eSpark-Backup/shocksensor-george/Hardware-Designing/Deliverables/Renderings/3D_Bottom_View.PNG

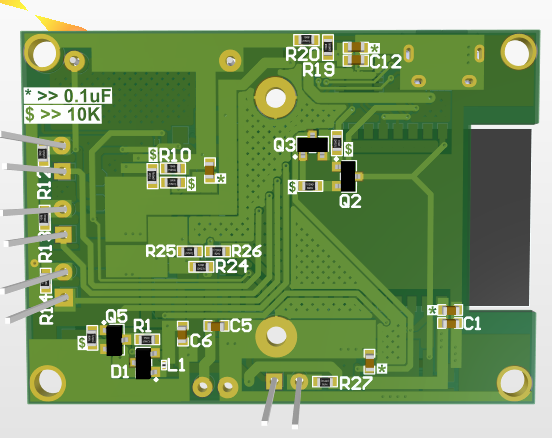
Hardware-Designing/Deliverables/Renderings/3D_Bottom_View.PNG
