eSpark-Backup/shocksensor-george/Hardware-Designing/Deliverables/Renderings/2D_C_View.PNG

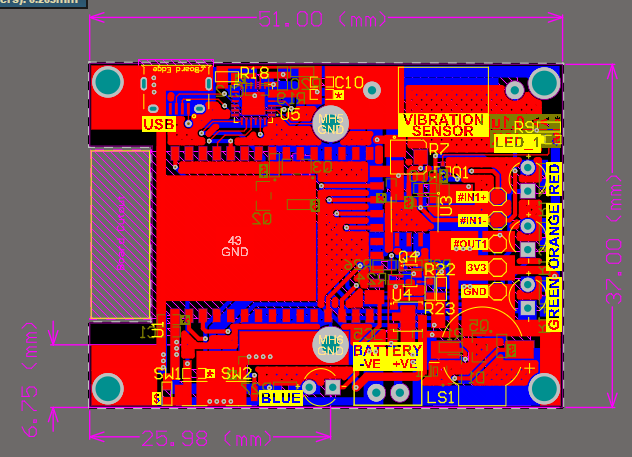
Hardware-Designing/Deliverables/Renderings/2D_C_View.PNG
