eSpark-Backup/shocksensor-george/README.md

# ShockSensor-George
 For Hardware and Software Development of ShockSensor-PCB for Spima Ltd.

## Project Documents
### New Design Proposal
https://docs.google.com/document/d/1cwAtrIecVFzTGOgoKfXupc5CIA_wZs_i1ySnAws0fEk/edit?usp=sharing

### Current Design Rework
https://docs.google.com/document/d/1-ERZRN2x7w0QCunjctplsGUNkxZJDdCkyaSeu2aAGT0/edit#heading=h.7z0ya98mlv53
