eSpark-Backup/shocksensor-george/Hardware-Designing/Design-Files/Shock_Sensor.PcbDoc.htm

Reporting Options

# File in Newer Format

Date | : | 11/3/2021
Time | : | 11:41:44 PM
Filename | : | C:\Users\eSpark-37\Documents\GitHub\ShockSensor-George\Hardware-Designing\Design-Files\Shock_Sensor.PcbDoc

Version | Warning
Release 20.0 | CAUTION - Support of propagation delay for primitives

This file was generated by a later version of the software
