eSpark-Backup/shocksensor-george/Hardware-Designing/Design-Files/MessageListReport.html

Altium customize

# Message List

Date: | | 9/13/2021
Time: | | 1:54:38 AM
Elapsed Time: | | 00:00:00

Class | Document | Source | Message | Time | Date | No.
[Error] | Controller_Section.SchDoc | Compiler | Duplicate Net Names Wire #OUT1 | 1:18:53 AM | 9/13/2021 | 1
[Warning] | Sensor_Section.SchDoc | Compiler | Global Power-Object GND at 1700mil,1050mil has been reduced to local level by presence of port at 1000mil,1050mil | 1:18:53 AM | 9/13/2021 | 2
[Warning] | Power_Section.SchDoc | Compiler | Global Power-Object GND at 1700mil,1050mil has been reduced to local level by presence of port at 1000mil,1050mil | 1:18:53 AM | 9/13/2021 | 3
[Warning] | Controller_Section.SchDoc | Compiler | Global Power-Object GND at 1700mil,1800mil has been reduced to local level by presence of port at 1000mil,1800mil | 1:18:53 AM | 9/13/2021 | 4
[Warning] | Connector_Section.SchDoc | Compiler | Global Power-Object GND at 1700mil,2050mil has been reduced to local level by presence of port at 1000mil,2050mil | 1:18:53 AM | 9/13/2021 | 5
[Warning] | ADC_Section.SchDoc | Compiler | Global Power-Object GND at 1700mil,2050mil has been reduced to local level by presence of port at 1000mil,2050mil | 1:18:53 AM | 9/13/2021 | 6
[Warning] | Power_Section.SchDoc | Compiler | Global Power-Object VBAT at 1700mil,1200mil has been reduced to local level by presence of port at 1000mil,1200mil | 1:18:53 AM | 9/13/2021 | 7
[Warning] | ADC_Section.SchDoc | Compiler | Global Power-Object VBAT at 1700mil,2200mil has been reduced to local level by presence of port at 1000mil,2200mil | 1:18:53 AM | 9/13/2021 | 8
[Warning] | Connector_Section.SchDoc | Compiler | Global Power-Object VBAT at 1700mil,2200mil has been reduced to local level by presence of port at 1000mil,2200mil | 1:18:53 AM | 9/13/2021 | 9
[Warning] | Connector_Section.SchDoc | Compiler | Global Power-Object VBUS at 1700mil,2350mil has been reduced to local level by presence of port at 1000mil,2350mil | 1:18:53 AM | 9/13/2021 | 10
[Warning] | Sensor_Section.SchDoc | Compiler | Global Power-Object VCC_3V3 at 1700mil,1200mil has been reduced to local level by presence of port at 1000mil,1200mil | 1:18:53 AM | 9/13/2021 | 11
[Warning] | Power_Section.SchDoc | Compiler | Global Power-Object VCC_3V3 at 1700mil,1350mil has been reduced to local level by presence of port at 1000mil,1350mil | 1:18:53 AM | 9/13/2021 | 12
[Warning] | Controller_Section.SchDoc | Compiler | Global Power-Object VCC_3V3 at 1700mil,1950mil has been reduced to local level by presence of port at 1000mil,1950mil | 1:18:53 AM | 9/13/2021 | 13
[Warning] | ADC_Section.SchDoc | Compiler | Global Power-Object VCC_3V3 at 1700mil,2350mil has been reduced to local level by presence of port at 1000mil,2350mil | 1:18:53 AM | 9/13/2021 | 14
[Warning] | Connector_Section.SchDoc | Compiler | Global Power-Object VCC_3V3 at 1700mil,2500mil has been reduced to local level by presence of port at 1000mil,2500mil | 1:18:53 AM | 9/13/2021 | 15
[Warning] | Sensor_Section.SchDoc | Compiler | Off grid Net Label #IN1+ at 8315.256mil,2700mil | 1:18:53 AM | 9/13/2021 | 16
[Warning] | Controller_Section.SchDoc | Compiler | Off grid Net Label DTR at 7005mil,4400mil | 1:18:53 AM | 9/13/2021 | 17
[Warning] | Controller_Section.SchDoc | Compiler | Off grid Net Label RTS at 7005mil,3250mil | 1:18:53 AM | 9/13/2021 | 18

Back to top
