eSpark-Backup/shocksensor-george/Hardware-Designing/_Client Shared Files/Shock_Sensor_PCB/bot.png

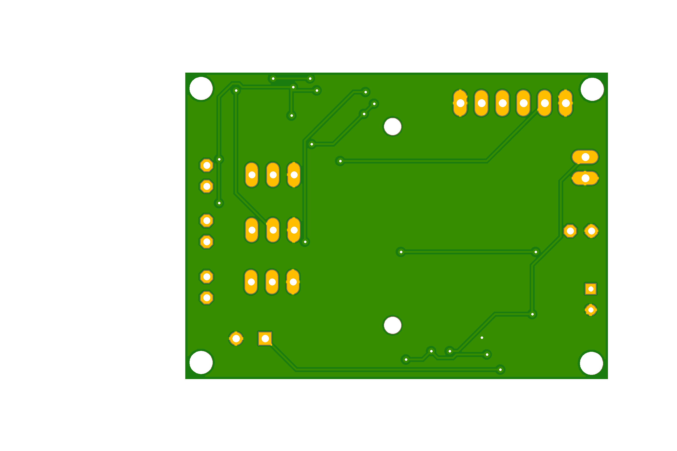
Hardware-Designing/_Client Shared Files/Shock_Sensor_PCB/bot.png
