eSpark-Backup/shocksensor-george/Hardware-Designing/_Shock_Sensor_PCB/top.png

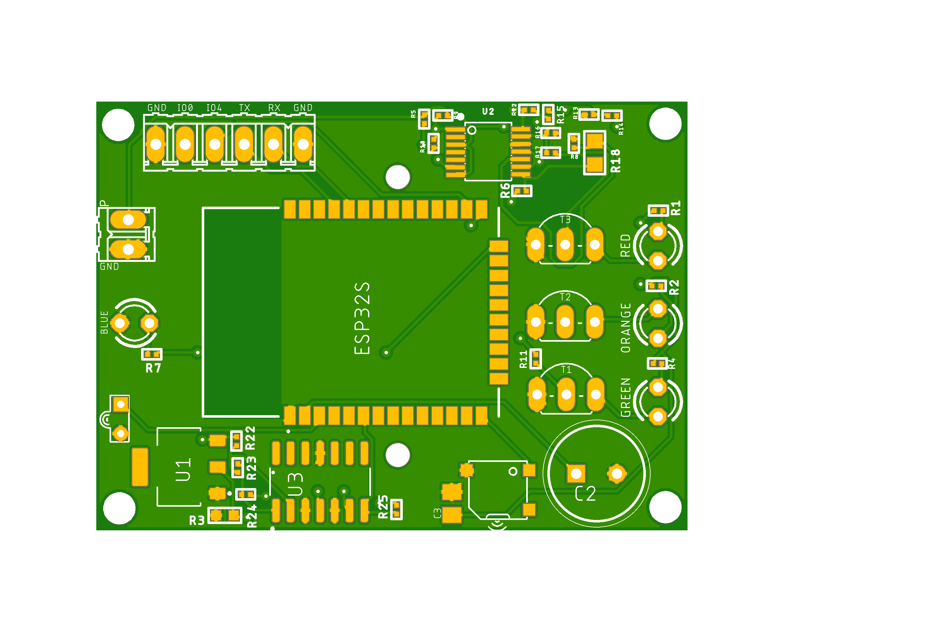
Hardware-Designing/_Shock_Sensor_PCB/top.png
