eSpark-Backup/shocksensor-george/Hardware-Designing/Deliverables/Renderings/2D_Top_View.PNG

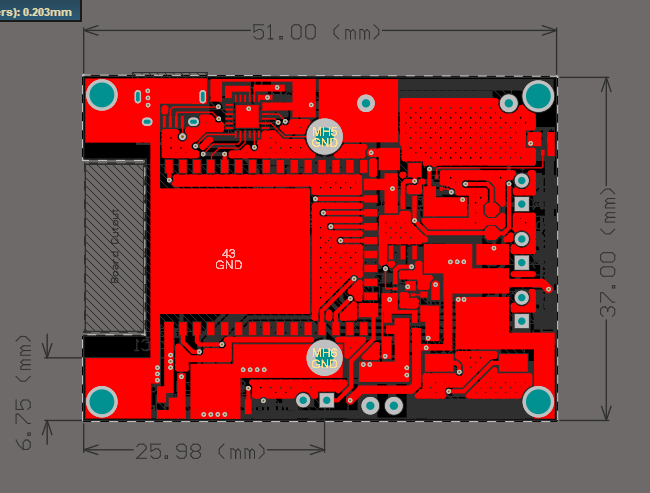
Hardware-Designing/Deliverables/Renderings/2D_Top_View.PNG
