eSpark-Backup/shocksensor-george/Hardware-Designing/Deliverables/Renderings/Isometric_View.PNG

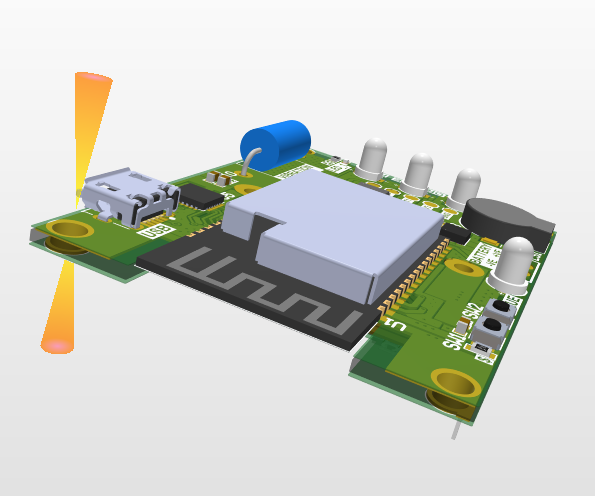
Hardware-Designing/Deliverables/Renderings/Isometric_View.PNG
