eSpark-Backup/shocksensor-george/Hardware-Designing/Deliverables/BOM/Digikey BOM.xlsx

Bill of Material (BOM) for George (Rack Monitor)
S. No. | Components | Description | Designator | Footprint (Package) | Manufacturer Part Number | Manufacturer | Alternate | Value | Quantity (Per Board) | Quantity 5 | Link | Unit Cost(1) | Total Cost(1) | Unit Cost (5 Boards) | Total Cost (5) | Remarks
1 | Capacitors | CAP CER 0.1UF 50V X7R 0603 | C2, C3, C4, C11, C13, C14 | CAP-0603 | CL10B104KB8NNNL | Samsung | - | 0.1uF | 6 | 30 | Digikey (https://www.digikey.com/en/products/detail/samsung-electro-mechanics/CL10B104KB8NNNL/3894274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) | $0.10000 | $0.60000 | $0.03100 | $0.93000
2 |  | CAP CER 22UF 16V X5R 0603 | C1 | CAP-0603 | CL10A226MO7JZNC | Samsung | - | 22uF | 1 | 5 | Digikey (https://www.digikey.com/en/products/detail/samsung-electro-mechanics/CL10A226MO7JZNC/7320581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) | $0.67000 | $0.67000 | $0.67000 | $3.35000
3 |  | CAP CER 4.7UF 25V X5R 0603 | C10, C12 | CAP-0603 | GRM188R61E475KE11D | Murata | - | 4.7uF | 2 | 10 | Digikey (https://www.digikey.com/en/products/detail/murata-electronics/GRM188R61E475KE11D/3900465) | $0.37000 | $0.74000 | $0.25800 | $2.58000
4 |  | CAP CER 1UF 25V X5R 0603 | C5, C6 | CAP-0603 | CL10A105KA8NNNC | Samsung | - | 1uF | 2 | 10 | Digikey (https://www.digikey.com/en/products/detail/samsung-electro-mechanics/CL10A105KA8NNNC/3886760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) | $0.10000 | $0.20000 | $0.03500 | $0.35000
5 | LED | LED GREEN CLEAR CHIP SMD | LED1 | LED 0402 | XZVG68W-2 | SunLED | - | - | 1 | 5 | Digikey (https://www.digikey.com/en/products/detail/sunled/XZVG68W-2/4745975?s=N4IgTCBcDaIBoC0BqBxAbADgOoFoIF0BfIA) | $0.37000 | $0.37000 | $0.37000 | $1.85000
6 |  | LED RED CLEAR T/H | LED2 | Through_Hole_LED | 204-10SURT/S530-A3 | Everlight | - | - | 1 | 5 | Digikey (https://www.digikey.com/en/products/detail/sunled/XLMDK65D/13559277) | $0.39000 | $0.39000 | $0.39000 | $1.95000
7 |  | LED ORANGE CLEAR 3MM T/H | LED3 | Through_Hole_LED | 204-10UYOC/S530-A3-L | Everlight | - | - | 1 | 5 | Digikey (https://www.digikey.com/en/products/detail/vishay-semiconductor-opto-division/TLHF4900/1681231) | $0.52000 | $0.52000 | $0.52000 | $2.60000
8 |  | 3MM YELLOW GREEN LED LAMP | LED4 | Through_Hole_LED | 204-10SYGC/S530-E2-L | Everlight | - | - | 1 | 5 | Digikey (https://www.digikey.com/en/products/detail/american-opto-plus-led/L314GT/13165175) | $0.25000 | $0.25000 | $0.25000 | $1.25000
9 |  | LED BLUE CLEAR 3MM T/H | LED5 | Through_Hole_LED | 204-10SUBC/C470/S400-A4 | Everlight | - | - | 1 | 5 | Digikey (https://www.digikey.com/en/products/detail/inolux/INL-3AB30/7604618) | $0.37000 | $0.37000 | $0.37000 | $1.85000
10 | Diode | DIODE GEN PURP 50V 215MA SOT23 | D1 | sot-23 | BAL74,215 | Nexperia | - | - | 1 | 5 | Digikey (https://www.digikey.com/en/products/detail/nexperia-usa-inc/BAL74-215/1127177) | $0.24000 | $0.24000 | $0.24000 | $1.20000
11 | Mosfet | MOSFET N-Channel 60V 0.115A SOT523 | Q1 | SOT-523 | 2N7002T-7-F | Diodes | - | - | 1 | 5 | Digikey (https://www.digikey.com/en/products/detail/diodes-incorporated/2N7002T-7-F/814963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) | $0.44000 | $0.44000 | $0.44000 | $2.20000
12 |  | TRANS NPN 40V 0.6A SMD SOT23-3 | Q2, Q3 | sot-23 | MMBT2222A-7-F | Diodes | - | - | 2 | 10 | Digikey (https://www.digikey.com/en/products/detail/diodes-incorporated/MMBT2222A-7-F/814503) | $0.14000 | $0.28000 | $0.13200 | $1.32000
13 |  | MOSFET N/P-CH 60V/50V SC70-6 | Q4 | SOT-363 | BSS8402DW-7-F | Diodes | - | - | 1 | 5 | Digikey (https://www.digikey.com/en/products/detail/diodes-incorporated/BSS8402DW-7-F/815002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) | $0.55000 | $0.55000 | $0.55000 | $2.75000
14 |  | MOSFET N-CH 50V 200MA SOT-23 | Q5 | sot-23 | BSS138LT1G | onsemi | - | - | 1 | 5 | Digikey (https://www.digikey.com/en/products/detail/onsemi/BSS138LT1G/918376?s=N4IgTCBcDaIEIGUEEYDMAOAMgFWQcRAF0BfIA) | $0.36000 | $0.36000 | $0.36000 | $1.80000
15 | Inductor | FERRITE BEAD 600 OHM 0201 1LN | L1 | IND 0201 | MMZ0603S601CT000 | TDK Corporation | - | - | 1 | 5 | Digikey (https://www.digikey.com/en/products/detail/tdk-corporation/MMZ0603S601CT000/765038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) | $0.13000 | $0.13000 | $0.13000 | $0.65000
16 | Buzzer | NO 2700Hz 85dB @ 3V, 10cm 3V Φ9mm SMD,9x3.2mm Buzzers RoHS | LS1 | Custom | YS-SBZ9032C03R16 | Fengming | AST0927MW-03TRQ | - | 1 | 5 | Digikey (https://www.digikey.com/en/products/detail/mallory-sonalert-products-inc/AST0927MW-03TRQ/11568847) | $1.64000 | $1.64000 | $1.64000 | $8.20000
17 | Resistors | RES SMD 10K OHM 5% 1/5W 0603 | R2, R6, R8, R11, R15, R16 | RES-0603 | CRGH0603J10K | TE Connectivity | - | 10K | 6 | 30 | Digikey (https://www.digikey.com/en/products/detail/te-connectivity-passive-product/CRGH0603J10K/2385379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) | $0.10000 | $0.60000 | $0.05800 | $1.74000
18 |  | TRIMMER 10K OHM 0.1W J LEAD TOP | R7 | Custom | TC33X-2-103E | Bourns Inc. | - | 10K | 1 | 5 | Digikey (https://www.digikey.com/en/products/detail/bourns-inc/TC33X-2-103E/612858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) | $0.26000 | $0.26000 | $0.26000 | $1.30000
19 |  | RES SMD 4.7K OHM 1% 1/10W 0603 | R9, R26 | RES-0603 | RC0603FR-074K7L | YAGEO | - | 4.7K | 2 | 10 | Digikey (https://www.digikey.com/en/products/detail/yageo/RC0603FR-074K7L/727212) | $0.10000 | $0.20000 | $0.10000 | $1.00000
20 |  | RES 470K OHM 1% 1/10W 0603 | R10 | RES-0603 | RC0603FR-13470KL | YAGEO | - | 470K | 1 | 5 | Digikey (https://www.digikey.com/en/products/detail/yageo/RC0603FR-13470KL/13694191) | $0.10000 | $0.10000 | $0.10000 | $0.50000
21 |  | RES SMD 560 OHM 1% 1/10W 0603 | R12, R13, R14, R27 | RES-0603 | RC0603FR-07560RL | YAGEO | - | 560R | 4 | 20 | Digikey (https://www.digikey.com/en/products/detail/yageo/RC0603FR-07560RL/727304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) | $0.10000 | $0.40000 | $0.02400 | $0.48000
22 |  | RES 1K OHM 5% 1/10W 0603 | R18 | RES-0603 | RMCF0603JJ1K00 | Stackpole | - | 1K | 1 | 5 | Digikey (https://www.digikey.com/en/products/detail/stackpole-electronics-inc/RMCF0603JJ1K00/6053783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) | $0.10000 | $0.10000 | $0.10000 | $0.50000
23 |  | RES SMD 22.1K OHM 1% 1/10W 0603 | R19 | RES-0603 | ERJ-3EKF2212V | Panasonic | - | 22.1K | 1 | 5 | Digikey (https://www.digikey.com/en/products/detail/panasonic-electronic-components/ERJ-3EKF2212V/196218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) | $0.10000 | $0.10000 | $0.10000 | $0.50000
24 |  | RES 47.5K OHM 1% 1/10W 0603 | R20 | RES-0603 | RC0603FR-0747K5L | YAGEO | - | 45.K | 1 | 5 | Digikey (https://www.digikey.com/en/products/detail/yageo/RC0603FR-0747K5L/727255) | $0.10000 | $0.10000 | $0.10000 | $0.50000
25 |  | RES SMD 47 OHM 0.1% 1/10W 0603 | R1 | RES-0603 | RT0603BRD0747RL | YAGEO | - | 47R | 1 | 5 | Digikey (https://www.digikey.com/en/products/detail/yageo/RT0603BRD0747RL/1072545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) | $0.34000 | $0.34000 | $0.34000 | $1.70000
26 |  | RES 100K OHM 5% 1/10W 0603 | R22, R23, R24, R25 | RES-0603 | RC0603JR-07100KL | YAGEO | - | 100K | 4 | 20 | Digikey (https://www.digikey.com/en/products/detail/yageo/RC0603JR-07100KL/726698) | $0.10000 | $0.40000 | $0.10000 | $2.00000
27 | Sensor | Vibration sensor | S1 | Custom | SW-420 | ------- | ---- | - | 1 | 5 | Custom supplier | $1.20000 | $1.20000 | $1.20000 | $6.00000 | will be arrange from custom supplier
28 | Switch | SWITCH TACTILE SPST-NO 0.05A 12V | SW1, SW2 | Custom | B3U-1000P | Omron | - | - | 2 | 10 | Digikey (https://www.digikey.com/en/products/detail/omron-electronics-inc-emc-div/B3U-1000P/1534338) | $0.96000 | $1.92000 | $0.92700 | $9.27000
29 | IC | 18x31x3.3mm WiFi Modules ROHS | U1 | Custom | ESP32-S2-WROOM-I(4M) | Espressif Systems | - | - | 1 | 5 | Custom supplier | $4.80000 | $4.80000 | $4.80000 | $24.00000 | will be arrange from custom supplier
30 |  | IC COMP DUAL VOLT LP 8SOIC | U3 | 8-SOIC | LM393ADT | STMicroelectronics | - | - | 1 | 5 | Digikey (https://www.digikey.com/en/products/detail/stmicroelectronics/LM393ADT/725475) | $0.43000 | $0.43000 | $0.43000 | $2.15000
31 |  | IC REG LINEAR 3.3V 1A 6DFN | U4 | 6-DFN (3x3) | NCP692MN33T2G | onsemi | - | - | 1 | 5 | Digikey (https://www.digikey.com/en/products/detail/onsemi/NCP692MN33T2G/2194205) | $1.11000 | $1.11000 | $1.11000 | $5.55000
32 |  | IC USB TO UART BRIDGE QFN24 | U5 | QFN-24 | CP2102N-A02-GQFN24R | Silicon Labs | - | - | 1 | 5 | Mouser (https://eu.mouser.com/ProductDetail/Silicon-Labs/CP2102N-A02-GQFN24R) | $1.88000 | $1.88000 | $1.88000 | $9.40000
33 | Connector | CONN RCPT USB2.0 MICRO B SMD R/A | J1 | Custom | 10118194-0001LF | Amphenol | - | - | 1 | 5 | Digikey (https://www.digikey.com/en/products/detail/amphenol-icc-fci/10118194-0001LF/2785389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) | $0.45000 | $0.45000 | $0.45000 | $2.25000
34 |  | ~~Solder Bridge ON~~ | ~~SB1~~ | ~~Solder Bridge~~ | ~~Solder Bridge~~ | ~~----------~~ | ~~----------~~ | ~~-~~ | ~~1~~ | ~~5~~ | ~~-------~~ | ~~--------~~ | ~~----------~~ | ~~-------~~ | ~~-------~~ | ~~Do Not Mount~~
35 |  | ~~Test Point ON~~ | ~~P1, P2, P3, P4, P5~~ | ~~Custom~~ | ~~TEST POINT~~ | ~~--------~~ | ~~-----------~~ | ~~-~~ | ~~5~~ | ~~25~~ | ~~-------~~ | ~~-------~~ | ~~--------~~ | ~~--------~~ | ~~-------~~ | ~~Do Not Mount~~
 |  |  |  |  |  |  |  |  | Total Component Cost |  |  |  | $22.14 |  | $103.67
 |  |  |  |  |  |  |  |  | Single Board Cost |  |  |  | $22.14 |  | $20.73
