eSpark-Backup/shocksensor-george/Hardware-Designing/Deliverables/BOM/LCSC BOM.xlsx

Bill of Material (BOM) for George (Rack Monitor)
S. No. | Components | Description | Designator | Footprint (Package) | Manufacturer Part Number | Manufacturer | LCSC Part no: | Alternate | Value | Quantity (Per Board) | Quantity 5 | LCSC MOQ (1) | LCSC MOQ (5) | LCSC Link | Unit Cost(1) | Total Cost(1) | Unit Cost (5 Boards) | Total Cost (5) | Remarks
1 | Capacitors | CAP CER 0.1UF 50V X7R 0603 | C2, C3, C4, C11, C13, C14 | CAP-0603 | ~~CL10B104KB8NNNL~~ | Samsung | C76711 | CGA3E2X7R1H104KT0Y0N | 0.1uF | 6 | 30 | 50 | 50 | LCSC (https://www.lcsc.com/product-detail/Multilayer-Ceramic-Capacitors-MLCC-SMD-SMT_TDK-CGA3E2X7R1H104KT0Y0N_C76711.html) | $0.01270 | $0.63500 | $0.01270 | $0.63500
2 |  | CAP CER 22UF 16V X5R 0603 | C1 | CAP-0603 | CL10A226MO7JZNC | Samsung | C2762594 | - | 22uF | 1 | 5 | 5 | 10 | LCSC (https://www.lcsc.com/product-detail/Multilayer-Ceramic-Capacitors-MLCC-SMD-SMT_Samsung-Electro-Mechanics-CL10A226MO7JZNC_C2762594.html) | $0.17260 | $0.86300 | $0.17260 | $1.72600
3 |  | CAP CER 4.7UF 25V X5R 0603 | C10, C12 | CAP-0603 | GRM188R61E475KE11D | Murata | C90057 | - | 4.7uF | 2 | 10 | 10 | 20 | LCSC (https://www.lcsc.com/product-detail/Multilayer-Ceramic-Capacitors-MLCC-SMD-SMT_Murata-Electronics-GRM188R61E475KE11D_C90057.html) | $0.08160 | $0.81600 | $0.08160 | $1.63200
4 |  | CAP CER 1UF 25V X5R 0603 | C5, C6 | CAP-0603 | CL10A105KA8NNNC | Samsung | C5673 | - | 1uF | 2 | 10 | 50 | 50 | LCSC (https://www.lcsc.com/product-detail/Multilayer-Ceramic-Capacitors-MLCC-SMD-SMT_Samsung-Electro-Mechanics-CL10A105KA8NNNC_C5673.html) | $0.00440 | $0.22000 | $0.00440 | $0.22000
5 | LED | LED GREEN CLEAR CHIP SMD | LED1 | LED 0402 | ~~XZVG68W-2~~ | SunLED | C273602 | TJ-S1005SW4TGLC2G-A5 | - | 4 | 20 | 10 | 30 | LCSC (https://www.lcsc.com/product-detail/Light-Emitting-Diodes-span-style-background-color-ff0-LED-span_TOGIALED-TJ-S1005SW4TGLC2G-A5_C273602.html) | $0.05940 | $0.59400 | $0.05940 | $1.78200
6 |  | LED RED CLEAR T/H | LED2 | Through_Hole_LED | 204-10SURT/S530-A3 | Everlight | C282135 | - | - | 1 | 5 | 10 | 10 | LCSC (https://www.lcsc.com/product-detail/Light-Emitting-Diodes-LED_Everlight-Elec-204-10SURT-S530-A3_C282135.html) | $0.04220 | $0.42200 | $0.04220 | $0.42200
7 |  | LED ORANGE CLEAR 3MM T/H | LED3 | Through_Hole_LED | 204-10UYOC/S530-A3-L | Everlight | C99759 | - | - | 1 | 5 | 10 | 10 | LCSC (https://www.lcsc.com/product-detail/Light-Emitting-Diodes-LED_Everlight-Elec-204-10UYOC-S530-A3-L_C99759.html) | $0.05660 | $0.56600 | $0.05660 | $0.56600
8 |  | 3MM YELLOW GREEN LED LAMP | LED4 | Through_Hole_LED | 204-10SYGC/S530-E2-L | Everlight | C282136 | - | - | 1 | 5 | 10 | 10 | LCSC (https://www.lcsc.com/product-detail/Light-Emitting-Diodes-LED_Everlight-Elec-204-10SYGC-S530-E2-L_C282136.html) | $0.04260 | $0.42600 | $0.04260 | $0.42600
9 |  | LED BLUE CLEAR 3MM T/H | LED5 | Through_Hole_LED | 204-10SUBC/C470/S400-A4 | Everlight | C86726 | - | - | 1 | 5 | 5 | 10 | LCSC (https://www.lcsc.com/product-detail/Light-Emitting-Diodes-LED_Everlight-Elec-204-10SUBC-C470-S400-A4_C86726.html) | $0.10130 | $0.50650 | $0.10130 | $1.01300
10 | Diode | DIODE GEN PURP 50V 215MA SOT23 | D1 | sot-23 | BAL74,215 | Nexperia | C461224 | - | - | 1 | 5 | 10 | 10 | LCSC (https://www.lcsc.com/product-detail/Diodes-General-Purpose_Nexperia-BAL74-215_C461224.html) | $0.06170 | $0.61700 | $0.06170 | $0.61700
11 | Mosfet | MOSFET N-Channel 60V 0.115A SOT523 | Q1 | SOT-523 | 2N7002T-7-F | Diodes | C139445 | - | - | 1 | 5 | 2 | 7 | LCSC (https://www.lcsc.com/product-detail/MOSFETs_Diodes-Incorporated-2N7002T-7-F_C139445.html) | $0.24880 | $0.49760 | $0.24880 | $1.74160
12 |  | TRANS NPN 40V 0.6A SMD SOT23-3 | Q2, Q3 | sot-23 | MMBT2222A-7-F | Diodes | C94515 | - | - | 2 | 10 | 20 | 20 | LCSC (https://www.lcsc.com/product-detail/Bipolar-Transistors-BJT_Diodes-Incorporated-MMBT2222A-7-F_C94515.html) | $0.05060 | $1.01200 | $0.05060 | $1.01200
13 |  | MOSFET N/P-CH 60V/50V SC70-6 | Q4 | SOT-363 | BSS8402DW-7-F | Diodes | C156386 | - | - | 1 | 5 |  |  | Chipmall (https://www.chipmall.com/product_detail/Diodes-Incorporated/MOSFET/BSS8402DW-7-F_740484.html) | $0.08810 | $0.00000 | $0.08810 | $0.00000 | Non Stock in LCSC
14 |  | MOSFET N-CH 50V 200MA SOT-23 | Q5 | sot-23 | BSS138LT1G | onsemi | C82045 | - | - | 1 | 5 | 2 | 7 | LCSC (https://www.lcsc.com/product-detail/MOSFETs_onsemi-BSS138LT1G_C82045.html) | $0.18090 | $0.36180 | $0.18090 | $1.26630
15 | Inductor | FERRITE BEAD 600 OHM 0201 1LN | L1 | IND 0201 | MMZ0603S601CT000 | TDK Corporation | C275404 | - | - | 1 | 5 | 50 | 50 | LCSC (https://www.lcsc.com/product-detail/Ferrite-Beads_TDK-MMZ0603S601CT000_C275404.html) | $0.00540 | $0.27000 | $0.00540 | $0.27000
16 | Buzzer | NO 2700Hz 85dB @ 3V, 10cm 3V Φ9mm SMD,9x3.2mm Buzzers RoHS | LS1 | Custom | YS-SBZ9032C03R16 | Fengming | C409828 | - | - | 1 | 5 | 2 | 7 | LCSC (https://www.lcsc.com/product-detail/Buzzers_Fengming-YS-SBZ9032C03R16_C409828.html) | $0.54280 | $1.08560 | $0.54280 | $3.79960
17 | Resistors | RES SMD 10K OHM 5% 1/5W 0603 | R2, R6, R8, R11, R15, R16 | RES-0603 | ~~CRGH0603J10K~~ | TE Connectivity | C103210 | RTT03103JTP | 10K | 5 | 25 | 100 | 100 | LCSC (https://www.lcsc.com/product-detail/Chip-Resistor-Surface-Mount_RALEC-RTT03103JTP_C103210.html) | $0.00140 | $0.14000 | $0.00140 | $0.14000
18 |  | TRIMMER 10K OHM 0.1W J LEAD TOP | R7 | Custom | TC33X-2-103E | Bourns Inc. | - | - | 10K | 1 | 5 |  |  | Local Supplier | $0.47620 | $0.00000 | $0.47620 | $0.00000
19 |  | RES SMD 4.7K OHM 1% 1/10W 0603 | R9, R26 | RES-0603 | RC0603FR-074K7L | YAGEO | C99782 | - | 4.7K | 2 | 10 | 100 | 100 | LCSC (https://www.lcsc.com/product-detail/Chip-Resistor-Surface-Mount_YAGEO-RC0603FR-074K7L_C99782.html) | $0.00130 | $0.13000 | $0.00130 | $0.13000
20 |  | RES 470K OHM 1% 1/10W 0603 | R10 | RES-0603 | ~~RC0603FR-13470KL~~ | YAGEO | C103658 | RTT034703FTP | 470K | 1 | 5 | 100 | 100 | LCSC (https://www.lcsc.com/product-detail/Chip-Resistor-Surface-Mount_RALEC-RTT034703FTP_C103658.html) | $0.00240 | $0.24000 | $0.00240 | $0.24000
21 |  | RES SMD 560 OHM 1% 1/10W 0603 | R12, R13, R14 | RES-0603 | RC0603FR-07560RL | YAGEO | C114629 | - | 560R | 3 | 15 | 100 | 100 | LCSC (https://www.lcsc.com/product-detail/Chip-Resistor-Surface-Mount_YAGEO-RC0603FR-07560RL_C114629.html) | $0.00150 | $0.15000 | $0.00150 | $0.15000
22 |  | RES 1K OHM 5% 1/10W 0603 | R18 | RES-0603 | RMCF0603JJ1K00 | Stackpole | C103209 | - | 1K | 1 | 5 | 100 | 100 | LCSC (https://www.lcsc.com/product-detail/Chip-span-style-background-color-ff0-Resistor-span-Surface-Mount_RALEC-RTT03102JTP_C103209.html) | $0.00120 | $0.12000 | $0.00120 | $0.12000
23 |  | RES SMD 22.1K OHM 1% 1/10W 0603 | R19 | RES-0603 | ERJ-3EKF2212V | Panasonic | C25961 | - | 22.1K | 1 | 5 | 100 | 100 | LCSC (https://www.lcsc.com/product-detail/Chip-span-style-background-color-ff0-Resistor-span-Surface-Mount_UNI-ROYAL-Uniroyal-Elec-0603WAF2212T5E_C25961.html) | $0.00140 | $0.14000 | $0.00140 | $0.14000
24 |  | RES 47.5K OHM 1% 1/10W 0603 | R20 | RES-0603 | RC0603FR-0747K5L | YAGEO | C137715 | - | 47.5K | 1 | 5 | 100 | 100 | LCSC (https://www.lcsc.com/product-detail/Chip-Resistor-Surface-Mount_YAGEO-RC0603FR-0747K5L_C137715.html) | $0.00140 | $0.14000 | $0.00140 | $0.14000
25 |  | RES SMD 47 OHM 0.1% 1/10W 0603 | R1 | RES-0603 | RT0603BRD0747RL | YAGEO | C326724 | - | 47R | 1 | 5 | 20 | 20 | LCSC (https://www.lcsc.com/product-detail/Chip-Resistor-Surface-Mount_YAGEO-RT0603BRD0747RL_C326724.html) | $0.03680 | $0.73600 | $0.03680 | $0.73600
26 |  | RES 100K OHM 5% 1/10W 0603 | R22, R23, R24, R25 | RES-0603 | RC0603JR-07100KL | YAGEO | C100048 | - | 100K | 4 | 20 | 100 | 100 | LCSC (https://www.lcsc.com/product-detail/Chip-Resistor-Surface-Mount_YAGEO-RC0603JR-07100KL_C100048.html) | $0.00110 | $0.11000 | $0.00110 | $0.11000
27 | Sensor | Vibration sensor | S1 | Custom | SW-420 | - | - | - | - | 1 | 5 |  |  | Local Supplier | $0.31800 | $0.00000 | $0.31800 | $0.00000 | Non Stock in LCSC
28 | Switch | SWITCH TACTILE SPST-NO 0.05A 12V | SW1, SW2 | Custom | B3U-1000P | Omron | C231329 | - | - | 2 | 10 | 3 | 12 | LCSC (https://www.lcsc.com/product-detail/Tactile-Switches_Omron-Electronics-B3U-1000P_C231329.html) | $0.82230 | $2.46690 | $0.69070 | $8.28840
29 | IC | 18x31x3.3mm WiFi Modules ROHS | U1 | Custom | ESP32-S2-WROOM-I(4M) | Espressif Systems | C967026 | - | - | 1 | 5 | 2 | 6 | LCSC (https://lcsc.com/product-detail/WiFi-Modules_Espressif-Systems-ESP32-S2-WROOM-I-4M_C967026.html) | $5.05280 | $10.10560 | $5.05280 | $30.31680
30 |  | IC COMP DUAL VOLT LP 8SOIC | U3 | 8-SOIC | LM393ADT | STMicroelectronics | C136033 | - | - | 1 | 5 | 2 | 6 | LCSC (https://www.lcsc.com/product-detail/Comparators_STMicroelectronics-LM393ADT_C136033.html) | $0.29740 | $0.59480 | $0.29740 | $1.78440
31 |  | IC REG LINEAR 3.3V 1A 6DFN | U4 | 6-DFN (3x3) | NCP692MN33T2G | onsemi | C145519 | - | - | 1 | 5 | 2 | 6 | LCSC (https://www.lcsc.com/product-detail/Linear-Voltage-Regulators-LDO_onsemi-NCP692MN33T2G_C145519.html) | $1.70230 | $3.40460 | $1.70230 | $10.21380 | Less Stock in LCSC
32 |  | IC USB TO UART BRIDGE QFN24 | U5 | QFN-24_4x4 | CP2102N-A02-GQFN24R | Silicon Labs | C969151 | - | - | 1 | 5 | 2 | 6 | LCSC (https://www.lcsc.com/product-detail/USB-ICs_SILICON-LABS-CP2102N-A02-GQFN24R_C969151.html) | $5.20790 | $10.41580 | $5.20790 | $31.24740
33 | Connector | CONN RCPT USB2.0 MICRO B SMD R/A | J1 | Custom | 10118194-0001LF | Amphenol | C132563 | - | - | 1 | 5 | 2 | 6 | LCSC (https://www.lcsc.com/product-detail/USB-Connectors_Amphenol-ICC-10118194-0001LF_C132563.html) | $0.26130 | $0.52260 | $0.26130 | $1.56780
34 |  | ~~Solder Bridge ON~~ | ~~SB1~~ | ~~Custom~~ | ~~Solder Bridge~~ | ~~-~~ | ~~-~~ | ~~-~~ | ~~-~~ | ~~1~~ | ~~5~~ | ~~-~~ | ~~-~~ | ~~-~~ | ~~-~~ | ~~-~~ | ~~-~~ | ~~-~~ | ~~DONOT MOUNT~~
35 |  | ~~Test Point ON~~ | ~~P1, P2, P3, P4, P5~~ | ~~Custom~~ | ~~TEST POINT~~ | ~~-~~ | ~~-~~ | ~~-~~ | ~~-~~ | ~~5~~ | ~~25~~ | ~~-~~ | ~~-~~ | ~~-~~ | ~~-~~ | ~~-~~ | ~~-~~ | ~~-~~ | ~~DONOT MOUNT~~
 |  |  |  |  |  |  |  |  |  | Total Component Cost |  |  |  |  |  | $38.30880 |  | $102.45310
 |  |  |  |  |  |  |  |  |  | Single Board Cost |  |  |  |  |  |  |  | $20.49062
