eSpark-Backup/shocksensor-george/Hardware-Designing/_Client Shared Files/Shock_Sensor_PCB/BOM.xlsx

Part | Value | Device | Package | Description
BATTERY | MP-4-3 TAKACHI ELECTRONICS ENCLOSURE TAKACHI ELECTRONICS ENCLOSURE | M02 | 02P | AMP QUICK CONNECTOR
BLUE | Blue | LED3MM | LED3MM | LED
C2 | ECA0JM102BJ | ECA0JM102BJ | CAPPRD350W65D825H1250 | Cap Aluminum Lytic 1000uF 6.3V 20% (8 X 11.5mm) Radial 580mA 2000h 85C
C3 | 100uF | C-USC0805K | C0805K | CAPACITOR, American symbol
ESP32S | ESP-32S | ESP-32S | ESP-32S | WiFi-BT-BLE MCU module
GREEN | Green | LED3MM | LED3MM | LED
ORANGE | Orange | LED3MM | LED3MM | LED
R1 | ERJ-UP3J221V | R_0201 | R0201 | RESISTOR
R2 | ERJ-UP3J221V | R_0201 | R0201 | RESISTOR
R3 | RNCF0603DTE10K0 | R_0603 | R0603 | RESISTOR
R4 | ERJ-UP3J221V | R_0201 | R0201 | RESISTOR
R5 | RMCF0201JT10K0 | R_0201 | R0201 | RESISTOR
R6 | RMCF0201JT20K0 | R_0201 | R0201 | RESISTOR
R7 | ERJ-UP3J221V | R_0201 | R0201 | RESISTOR
R8 | RMCF0201JT10K0 | R_0201 | R0201 | RESISTOR
R9 | RMCF0201JT10K0 | R_0201 | R0201 | RESISTOR
R10 | RMCF0201JT10K0 | R_0201 | R0201 | RESISTOR
R11 | RMCF0201JT10K0 | R_0201 | R0201 | RESISTOR
R12 | RMCF0201JT10K0 | R_0201 | R0201 | RESISTOR
R13 | RMCF0201JT10K0 | R_0201 | R0201 | RESISTOR
R14 | RMCF0201JT10K0 | R_0201 | R0201 | RESISTOR
R15 | RMCF0201JT10K0 | R_0201 | R0201 | RESISTOR
R16 | RMCF0201JT10K0 | R_0201 | R0201 | RESISTOR
R17 | RMCF0201JT10K0 | R_0201 | R0201 | RESISTOR
R18 | PNM0805E5002BST5 | R_0805 | C0805 | RESISTOR
R22 | RMCF0201JT6K20 | R_0201 | R0201 | RESISTOR
R23 | RC0201JR-0710KL | R_0201 | R0201 | RESISTOR
R24 | RC0201JR-0710KL | R_0201 | R0201 | RESISTOR
R25 | RC0201JR-0710KL | R_0201 | R0201 | RESISTOR
RED | RED | LED3MM | LED3MM | LED
SL1 | Adafruit 2135 | M06 | 06P | AMP QUICK CONNECTOR
SPK1 | SMT-0540-S-R | SMT-0540-S-R | SMT-0540-S-R | SMT-0549-S-R
T1 | 2N2222 | 2N2222 | TO92-EBC-OVAL | NPN TRANSISTOR
T2 | 2N2222 | 2N2222 | TO92-EBC-OVAL | NPN TRANSISTOR
T3 | 2N2222 | 2N2222 | TO92-EBC-OVAL | NPN TRANSISTOR
U$1 | SW-18015P | SW-18015P | SW-18015P
U1 | AMS1117-3.3 | AMS1117-3.3 | SOT229P700X180-4N | Sot223/Pkg 1-Amp 3.3-Volt Low Drop Out Voltage Regulatator
U2 | LM339PWR | LM339 | TSSOP-14 | Quad Comparator - LM339PWR
U3 | LM324DR | LM324DR | SOIC127P600X175-14N | Check prices
