eSpark-Backup/shocksensor-george/Hardware-Designing/Deliverables/Rackmonitor.xlsx

Bill of Material (BOM) for Shock Sensor
S. No. | Components | Description | Designator | Footprint (Package) | Manufacturer Part Number | Manufacturer | LCSC Part no: | Alternate | Value | Quantity (Per Board) | Total MOQ | Quantity 5 | LCSC Link | Unit Cost(1) | Total Cost(1) | MOQ Total | Unit Cost (5 Boards) | Total Cost (5) | Remarks
1 | Capacitor | CL10 Series 0603 0.1 uF 50 V ±10% Tolerance X7R Multilayer Ceramic Capacitor, CAP CER 0.1UF 50V X7R 0603 | C1, C2, C3, C4, C11, C13 | CAP-0603 | CL10B104KB8NNNL | Samsung | C913912 | CC0603KRX7R9BB104 | 0.1uF | 6 | 100 | 30 | LCSC (https://www.lcsc.com/product-detail/Multilayer-Ceramic-Capacitors-MLCC-SMD-SMT_YAGEO-CC0603KRX7R9BB104_C14663.html) | 0.003 |  |  | 0.003
2 |  | Ceramic capacitor SMD-0603 1000nF/25V X7R# K +-10%, Samsung, RoHS | C5, C6 | CAP-0603 | CL10A105KA8NNNC | Samsung | C5673 |  | 1uF | 2 | 50 | 10 | LCSC (https://www.lcsc.com/product-detail/Multilayer-Ceramic-Capacitors-MLCC-SMD-SMT_Samsung-Electro-Mechanics-CL10A105KA8NNNC_C5673.html) | 0.0051 |  |  | 0.0051
3 |  | CAP CER 4.7UF 25V X5R 0603 | C10, C12 | CAP-0603 | GRM188R61E475KE11D | Murata | C90057 |  | 4.7uF | 2 | 20 | 10 | LCSC (https://www.lcsc.com/product-detail/Multilayer-Ceramic-Capacitors-MLCC-SMD-SMT_Murata-Electronics-GRM188R61E475KE11D_C90057.html) | 0.0576 |  |  | 0.0576
4 | LED | LED GREEN CLEAR CHIP SMD | D1, D2, D3, D4 | LED 0402 | XZVG68W-2 | SunLED | C273602 | TJ-S1005SW4TGLC2G-A5 |  | 4 | 30 | 20 | LCSC (https://www.lcsc.com/product-detail/Light-Emitting-Diodes-LED_TOGIALED-TJ-S1005SW4TGLC2G-A5_C273602.html) | 0.0632 |  |  | 0.0632
5 | Mosefet | MOSFET N-Channel 60V 0.115A SOT523 | Q1 | SOT-523 | 2N7002T-7-F | Diodes | C139445 |  |  | 1 | 10 | 5 | LCSC (https://www.lcsc.com/product-detail/MOSFETs_Diodes-Incorporated-2N7002T-7-F_C139445.html) | 0.1124 |  |  | 0.1124
6 |  | Trans GP BJT NPN 40V 0.6A 3-Pin SOT-23 T/R | Q2, Q3 | sot-23 | MMBT2222A-7-F | Diodes | C94515 |  |  | 2 | 20 | 10 | LCSC (https://www.lcsc.com/product-detail/Bipolar-Transistors-BJT_Diodes-Incorporated-MMBT2222A-7-F_C94515.html) | 0.0354 |  |  | 0.0354
7 | Resistor | Surface Mount Thick Film Resistor, CRG Series, 10 kohm, 200 mW, - 5%, 50 V, 0603 [1608 Metric] ;RoHS Compliant: Yes | R6, R8, R11, R15, R16 | RES-0603 | CRGH0603J10K | TE Connectivity Holsworthy | C103210 | RTT03103JTP | 10K | 5 | 100 | 25 | LCSC (https://www.lcsc.com/product-detail/Chip-Resistor-Surface-Mount_RALEC-RTT03103JTP_C103210.html) | 0.0012 |  |  | 0.0012
8 |  | TRIMMER 10K OHM 0.1W J LEAD TOP | R7 | TC33X-2-103E | TC33X-2-103E | Bourns |  |  | 10K | 1 |  | 5
9 |  | RES SMD 4.7K OHM 1% 1/10W 0603 | R9, R26 | RES-0603 | RC0603FR-074K7L | Yageo | C99782 |  | 4.7K | 2 | 100 | 10 | LCSC (https://www.lcsc.com/product-detail/Chip-Resistor-Surface-Mount_YAGEO-RC0603FR-074K7L_C99782.html) | 0.0016 |  |  | 0.0016
10 |  | Thick Film Resistors - SMD 470K OHM 1% | R10 | RES-0603 | RC0603FR-13470KL | Yageo | C103658 | RTT034703FTP | 470K | 1 | 100 | 5 | LCSC (https://www.lcsc.com/product-detail/Chip-Resistor-Surface-Mount_RALEC-RTT034703FTP_C103658.html) | 0.0017 |  |  | 0.0017
11 |  | YAGEO - RC0603FR-07560RL - SMD Chip Resistor, 0603 [1608 Metric], 560 ohm, RC Series, 75 V, Thick Film, 100 mW | R12, R13, R14 | RES-0603 | RC0603FR-07560RL | Yageo | C114629 |  | 560R | 3 | 100 | 15 | LCSC (https://www.lcsc.com/product-detail/Chip-Resistor-Surface-Mount_YAGEO-RC0603FR-07560RL_C114629.html) | 0.0019 |  |  | 0.0019
12 |  | RES 1K OHM 5% 1/10W 0603 | R18 | RES-0603 | RMCF0603JJ1K00 | Stackpole Electronics |  |  | 1K | 1 |  | 5
13 |  | RES SMD 22.1K OHM 1% 1/10W 0603 | R19 | RES-0603 | ERJ-3EKF2212V | Panasonic |  |  | 22.1K | 1 |  | 5
14 |  | Res Thick Film 0603 47.5K Ohm 1% 0.1W(1/10W) ±100ppm/C Epoxy SMD T/R | R20 | RES-0603 | RC0603FR-0747K5L | Yageo |  |  | 47.5K | 1 |  | 5
15 |  | RES SMD 0 OHM JUMPER 1/10W 0603 | R21 | RES-0603 | RC0603JR-070RP | Yageo |  |  | 0R | 1 |  | 5
16 |  | Res Thick Film 0603 100K Ohm 5% 1/10W 100ppm/C Molded SMD SMD Paper T/R | R22, R23, R24, R25 | RES-0603 | RC0603JR-07100KL | Yageo |  |  | 100K | 4 |  | 20
17 | Sensor | Vibration sensor | S1 | SW-420 | SW-420 |  |  |  |  | 1 |  | 5
18 | Switch | SWITCH TACTILE SPST-NO 0.05A 12V | SW1, SW2 | B3U-1000P | B3U-1000P | Omron |  |  |  | 2 |  | 10
19 | ICs | RX TXRX MOD WIFI TRACE ANT SMD | U1 | ESP32-WROOM-32D (8MB) | ESP32-WROOM-32D (8MB) | Espressif Systems |  |  |  | 1 |  | 5
20 |  | STMICROELECTRONICS - LM393ADT - Analogue Comparator, Low Power, 2 Comparators, 300 ns, 2V to 36V, ± 1V to ± 18V, SOIC, 8 Pins | U3 | 8-SOIC | LM393ADT | STMicroelectronics |  |  |  | 1 |  | 5
21 |  | ON Semiconductor NCP692MN33T2G, LDO Voltage Regulator, 1A, 3.3 V 2%, 1.5 6 Vin, 6-Pin DFN | U4 | 6-DFN (3x3) | NCP692MN33T2G | ON Semiconductor |  |  |  | 1 |  | 5
22 |  | IC USB TO UART BRIDGE QFN24 | U5 | CP2102N-A02-GQFN24R | CP2102N-A02-GQFN24R | Silicon Labs |  |  |  | 1 |  | 5
23 |  | DIODES INC. - BSS8402DW-7-F - Dual MOSFET, N and P Channel, 115 mA, 60 V, 13.5 ohm, 10 V, 2.5 V | U6 | SOT-363 | BSS8402DW-7-F | Diodes |  |  |  | 1 |  | 5
24 | Connector | CONN RCPT USB2.0 MICRO B SMD R/A | J1 | 10118194-0001LF | 10118194-0001LF | Amphenol FCI |  |  |  | 1 |  | 5
25 |  | Conn Shrouded Header (4 Sides) HDR 2 POS 2.5mm Solder ST Thru-Hole Box | J2 | B2B-XH-A(LF)(SN) | B2B-XH-A(LF)(SN) | JST |  |  |  | 1 |  | 5
26 |  | Test Point ON | P1, P2, P3, P4, P5 | TEST POINT | TEST POINT |  |  |  |  | 5 |  | 25
27 |  | Solder Bridge ON | SB1 | Solder Bridge | Solder Bridge |  |  |  |  | 1 |  | 5
