eSpark-Backup/shocksensor-george/Hardware-Designing/Deliverables/Supporting Files/Shock_Sensor.step

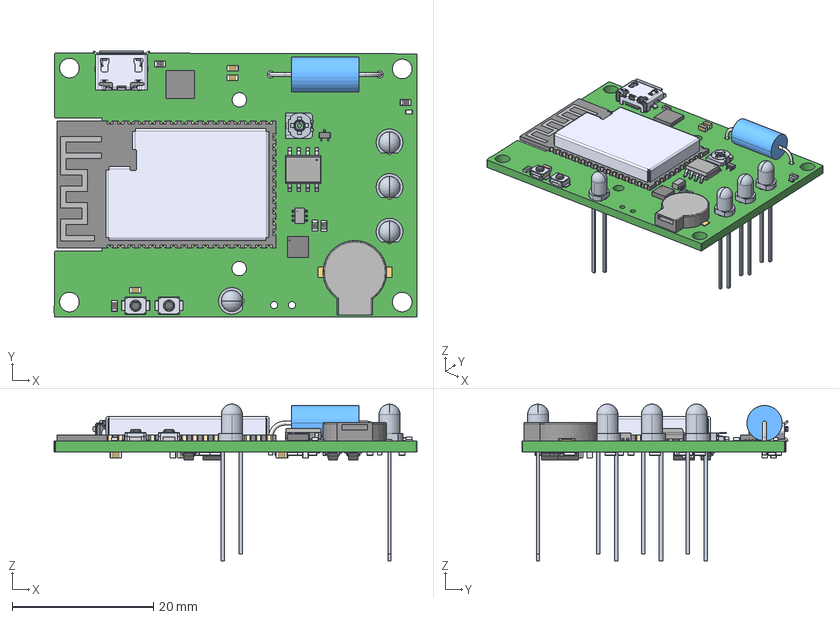
[picture p14: CAD file, 2022-03-07]
Hardware-Designing/Deliverables/Supporting Files/Shock_Sensor.step
51.3 x 37.7 x 22.2 mm
CUI_DEVICES_CMT-0926-86-SMT-TR
10118194-0001LF--3DModel-STEP-56544
CircuitWorks-SOT-23 x 4
ESP32-S2-WROOM--3DModel-STEP-269445
User_Library-RESC1608X05N x 21
Ferrite
bl420dx
User_Library-CAPC1608X09 x 11
SOT363_DIO
APHHS1005
User_Library-OMRON_B3U1000P x 2
20410UYOCS530A3 x 4
TC33_SUBST1
CP2102N-A02-GQFN24R--3DModel-STEP-56544
DFN6_3X3_ONS
SO8_STM
User_Library-SOT-523
