eSpark-Backup/shocksensor-george/Hardware-Designing/Design-Files/Shock_Sensor.step

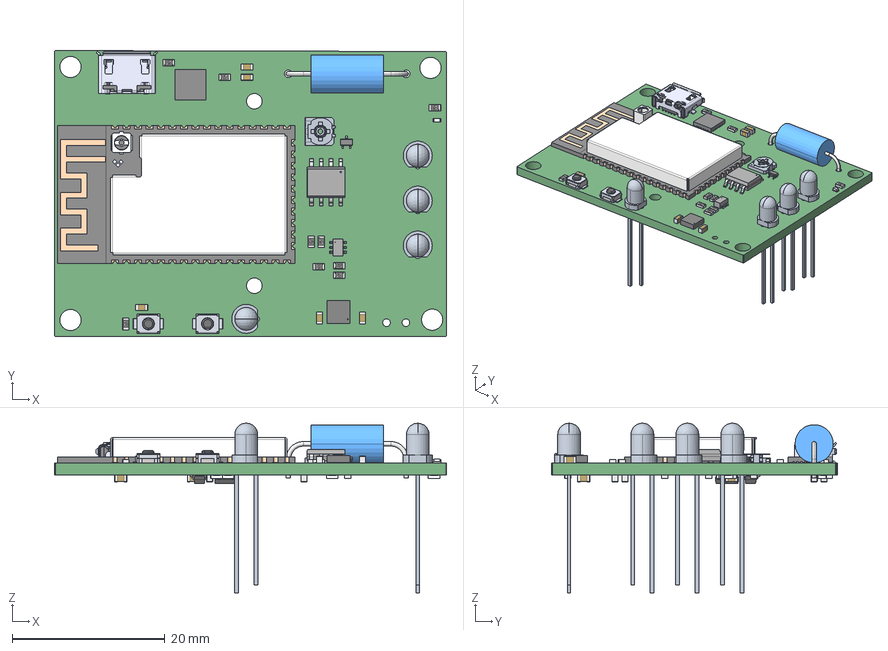
[picture p15: CAD file, 2021-11-03]
Hardware-Designing/Design-Files/Shock_Sensor.step
51.3 x 37.4 x 22.2 mm
Board
ESP32-S2-WROOM_M22S2H3200PH3Q0_
bl420dx
User_Library-CAPC1608X09 x 11
User_Library-RESC1608X05N x 20
SOT363_DIO
APHHS1005
10118194-0001LF--3DModel-STEP-56544
User_Library-OMRON_B3U1000P x 2
CircuitWorks-SOT-23 x 2
20410UYOCS530A3 x 4
TC33_SUBST1
CP2102N-A02-GQFN24R--3DModel-STEP-56544
DFN6_3X3_ONS
SO8_STM
User_Library-SOT-523
