eSpark-Backup/shocksensor-george/(list of files, cad)

Other CAD files:
Hardware-Designing/Deliverables/Supporting Files/Shock_Sensor.DWG
Hardware-Designing/Deliverables/Supporting Files/Shock_Sensor.DXF
