eSpark-Backup/shocksensor-george/Documents/Dev-files/Issues document.docx

ISSUES REPORT OF GEORGE PCB

Issues in the George’s PCB:

- Battery Status LEDs are not working as expected. One LED needed to be ON at a time but there were two LEDs lighting up (RED+ORANGE).
- The LEDs are driven by LM339 OpAmps and the circuit was built in such a way that lighting up one LED at a time is not possible because of voltage divider circuit. RED LED will light up if ORANGE OR GREEN is ON, which is not required.
- The reference voltages for OpAmps are 4.5v, which should be grounded.
- The PCB design is not according to the schematic given. Particularly, Resistor R24 is grounded in PCB which is not the case in schematic.
- There is an ADC output for voltage status input coming out of pin7 of LM324 IC and connected to IO34 of ESP32, It was giving 0V regardless whatever voltage we provide.
- A Resistor R3 is connected from power to ground with shock sensor, this resistor is a redundant element in the circuit.
- Enable pin was not given in PCB design and board.
