eSpark-Backup/shocksensor-george/Hardware-Designing/Design-Files/Rackmonitor.pdf

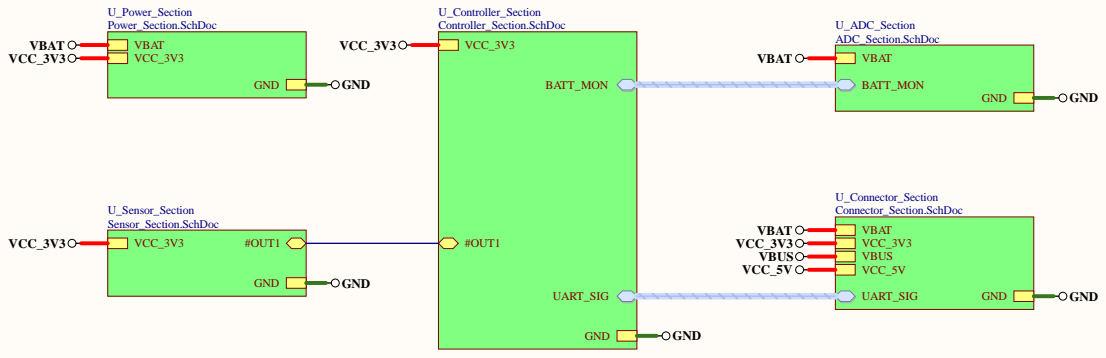
[picture p16: page 1]

Size A | Number | Revision

Date: 11/02/2021 | Sheet of
File: G:\Github\..\Top_Section.SchDoc | Drawn By:

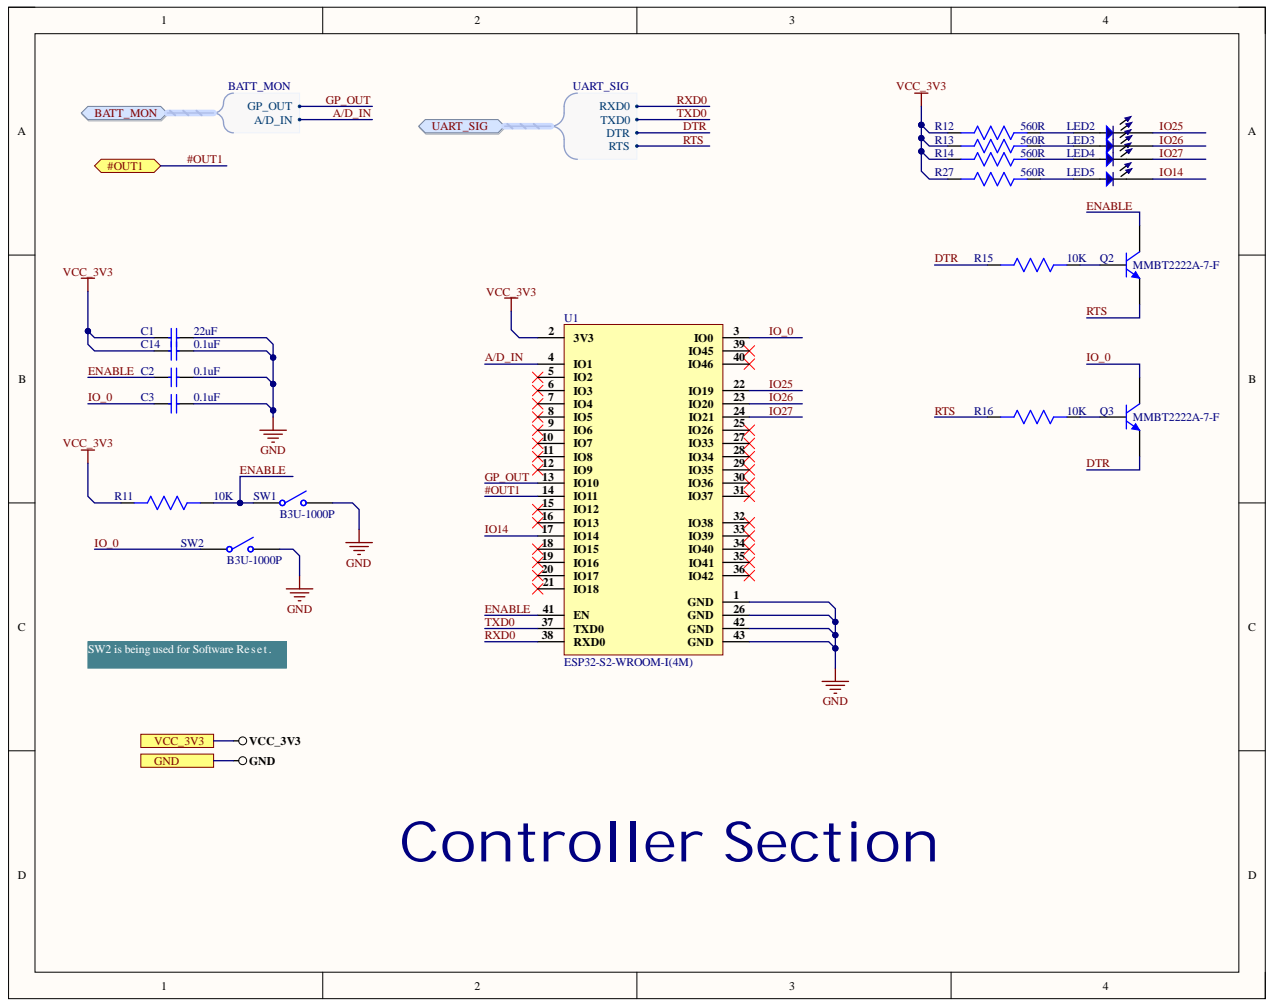
[picture p17: page 2]

SW2 is being used for Software Reset.

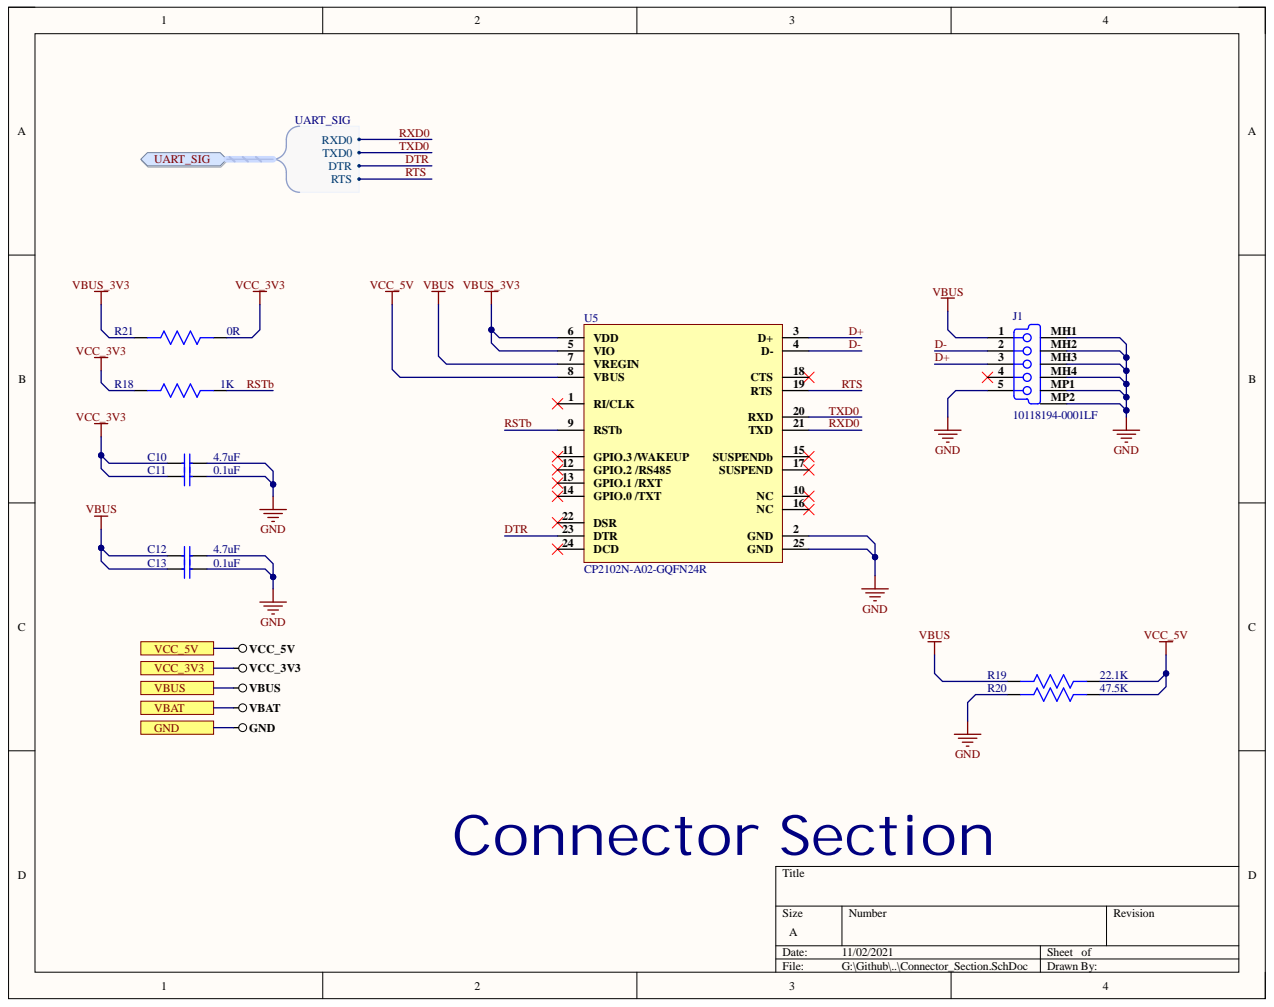
[picture p18: page 3]

Size | Nu mber | Revisio n

Date: 1/0 2/2 1 | Sheet o f
File: G:\Gith u b\..\C o n necto r_Sectio n.Sc hDo c | Dr aw n B y :

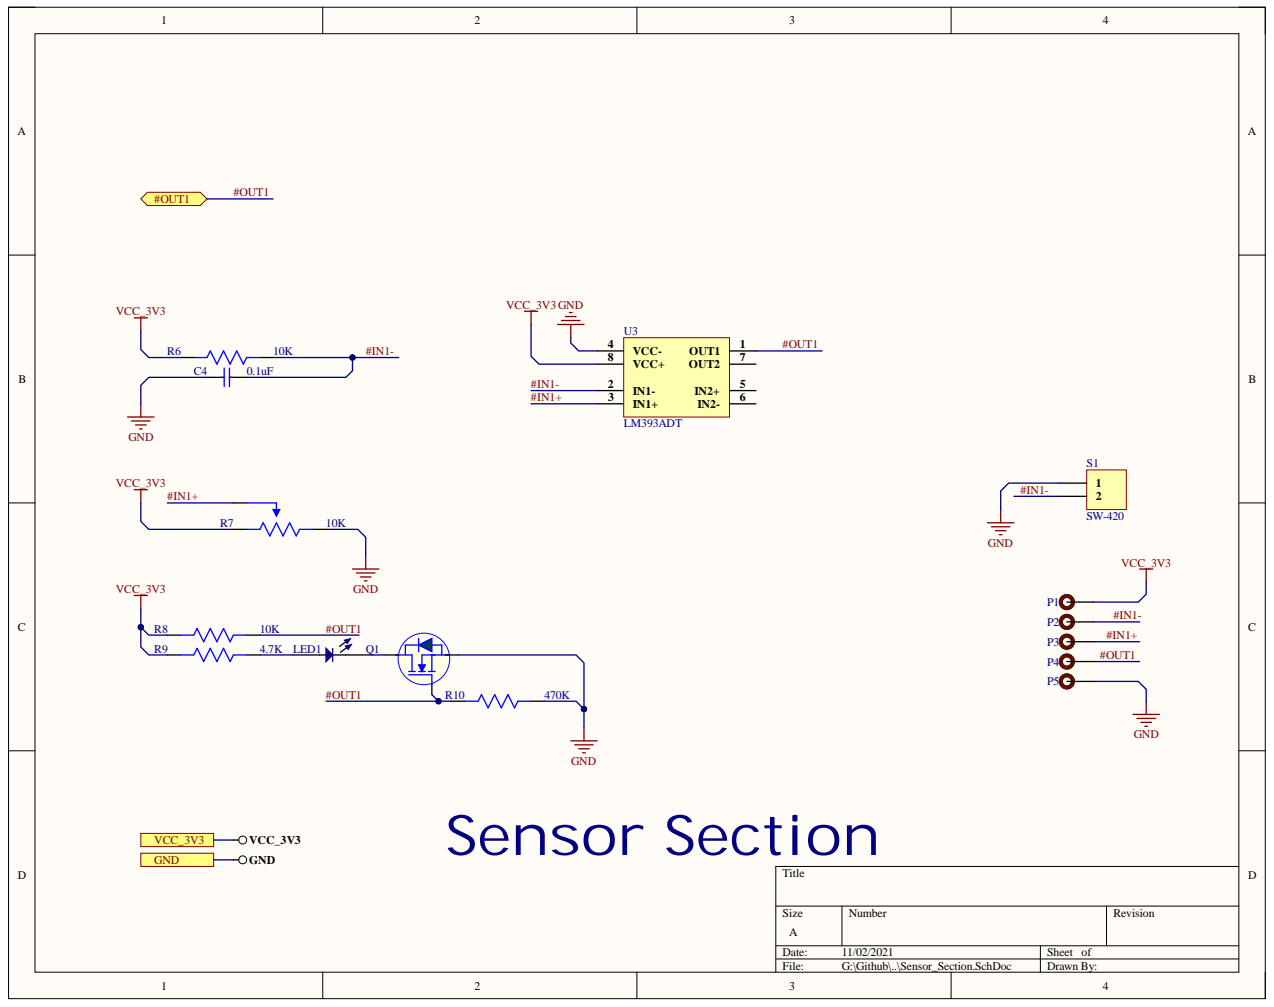
[picture p19: page 4]

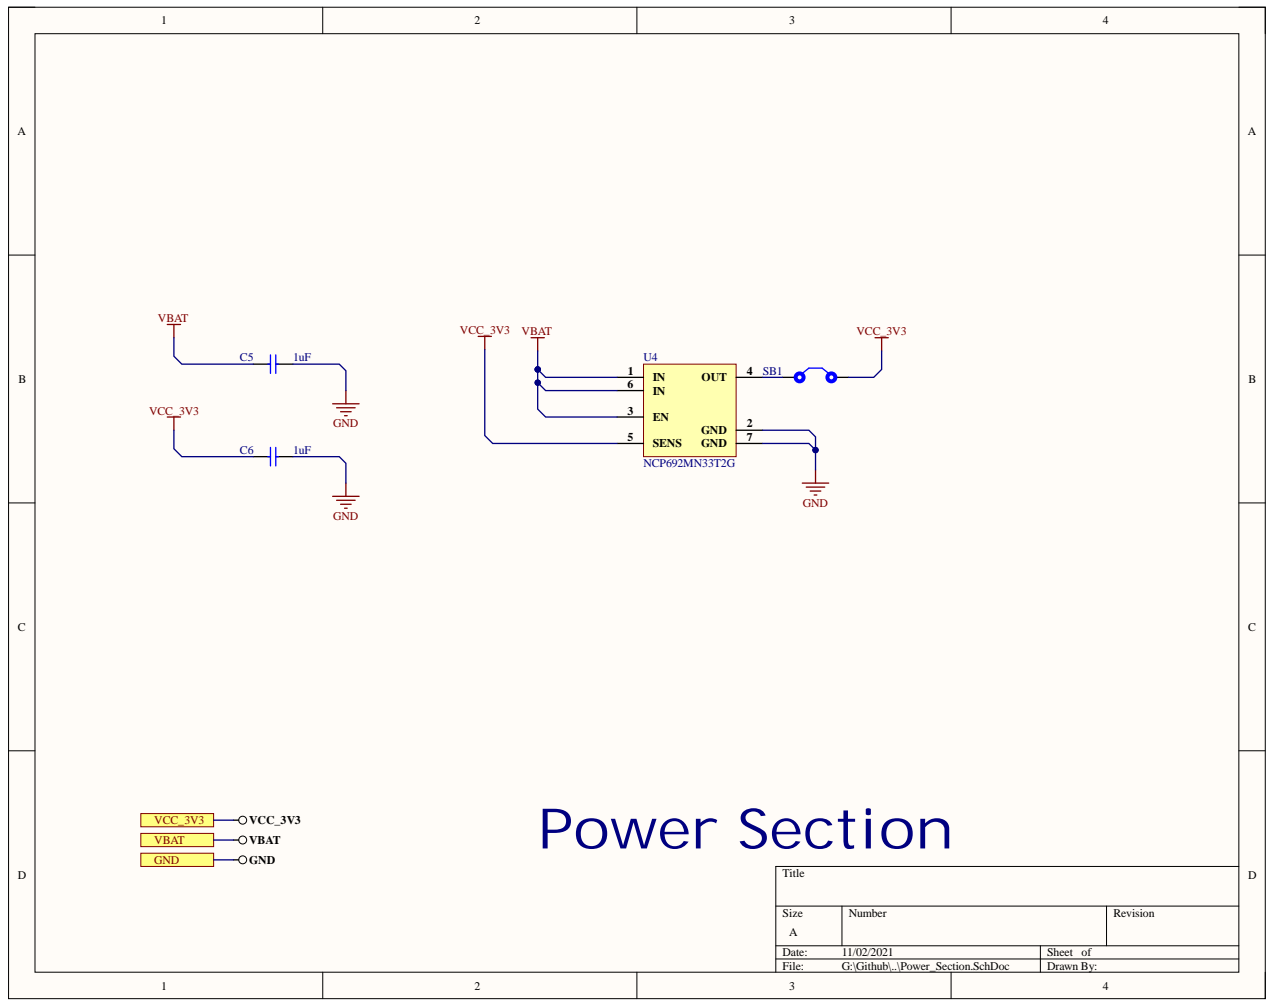
[picture p20: page 5]

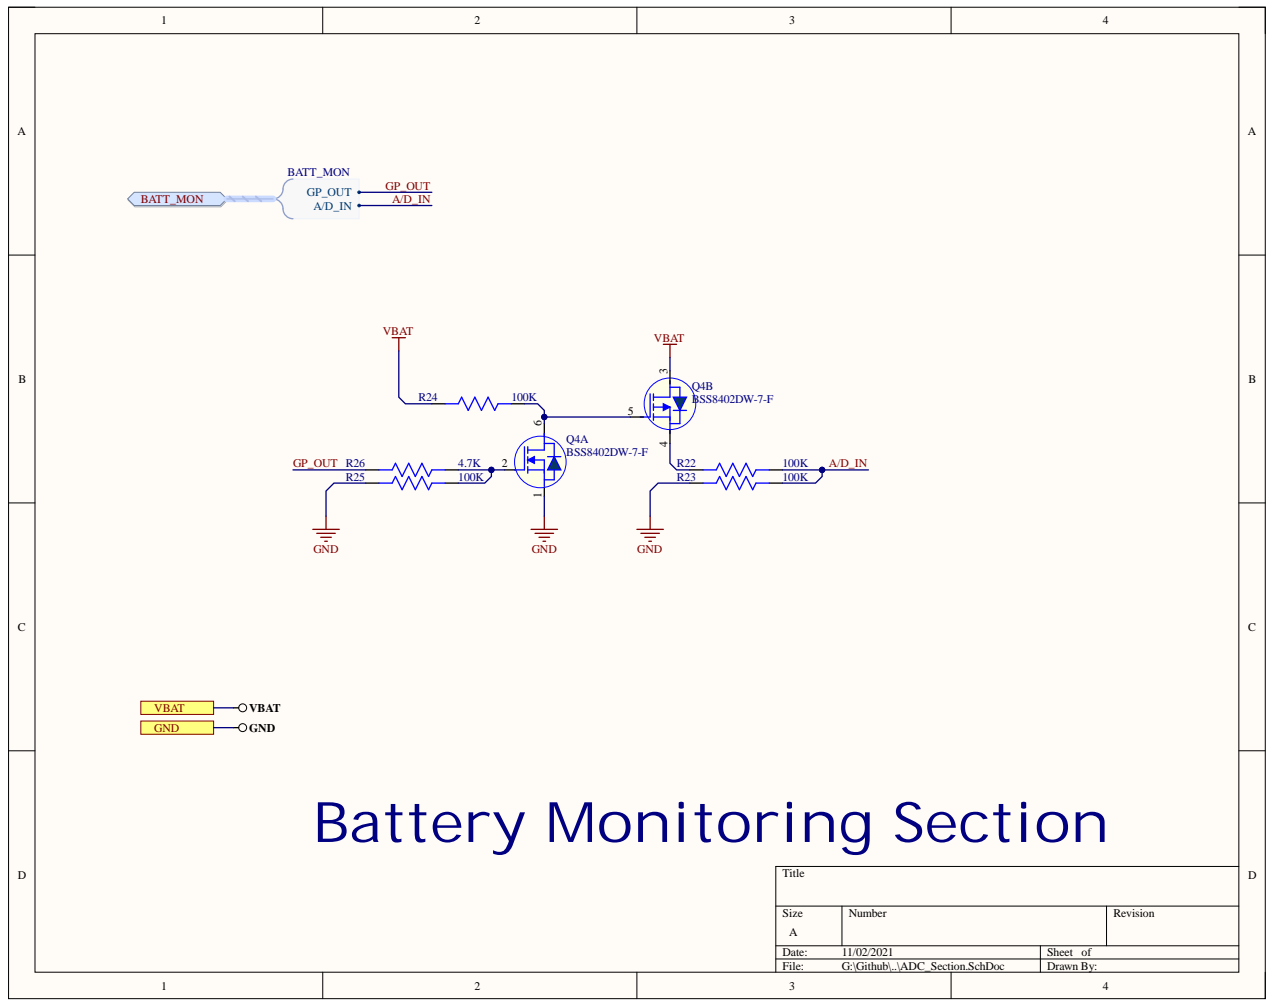
[picture p21: page 6]
