eSpark-Backup/shocksensor-george/Hardware-Designing/Reference-Design/George Task.pdf

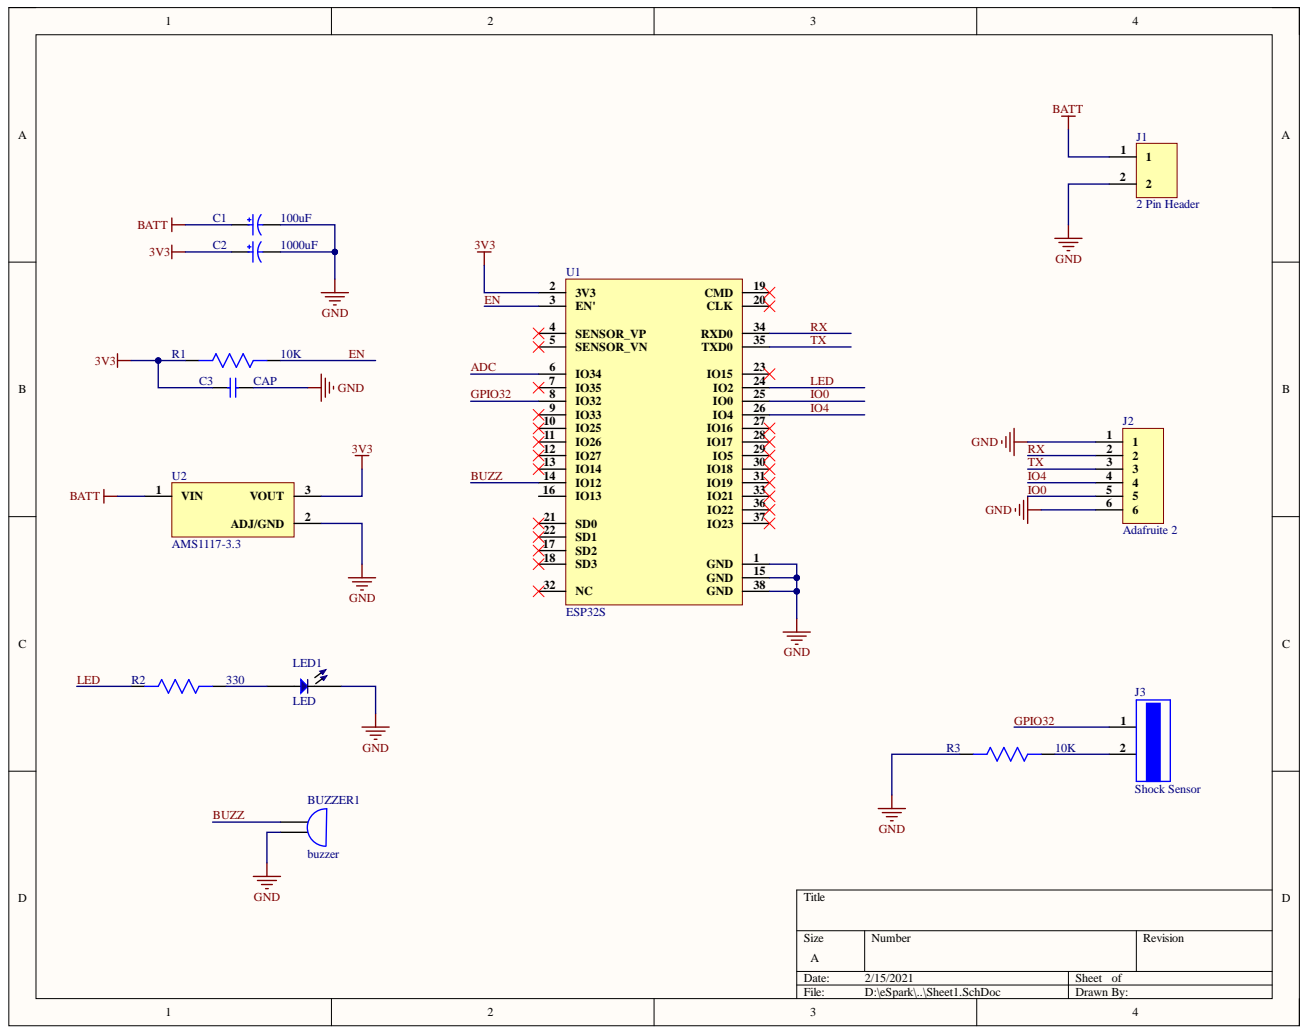
[picture p22: page 1]
