eSpark-Backup/shocksensor-george/Hardware-Designing/Deliverables/Schematic/Assembly_Drawing.pdf

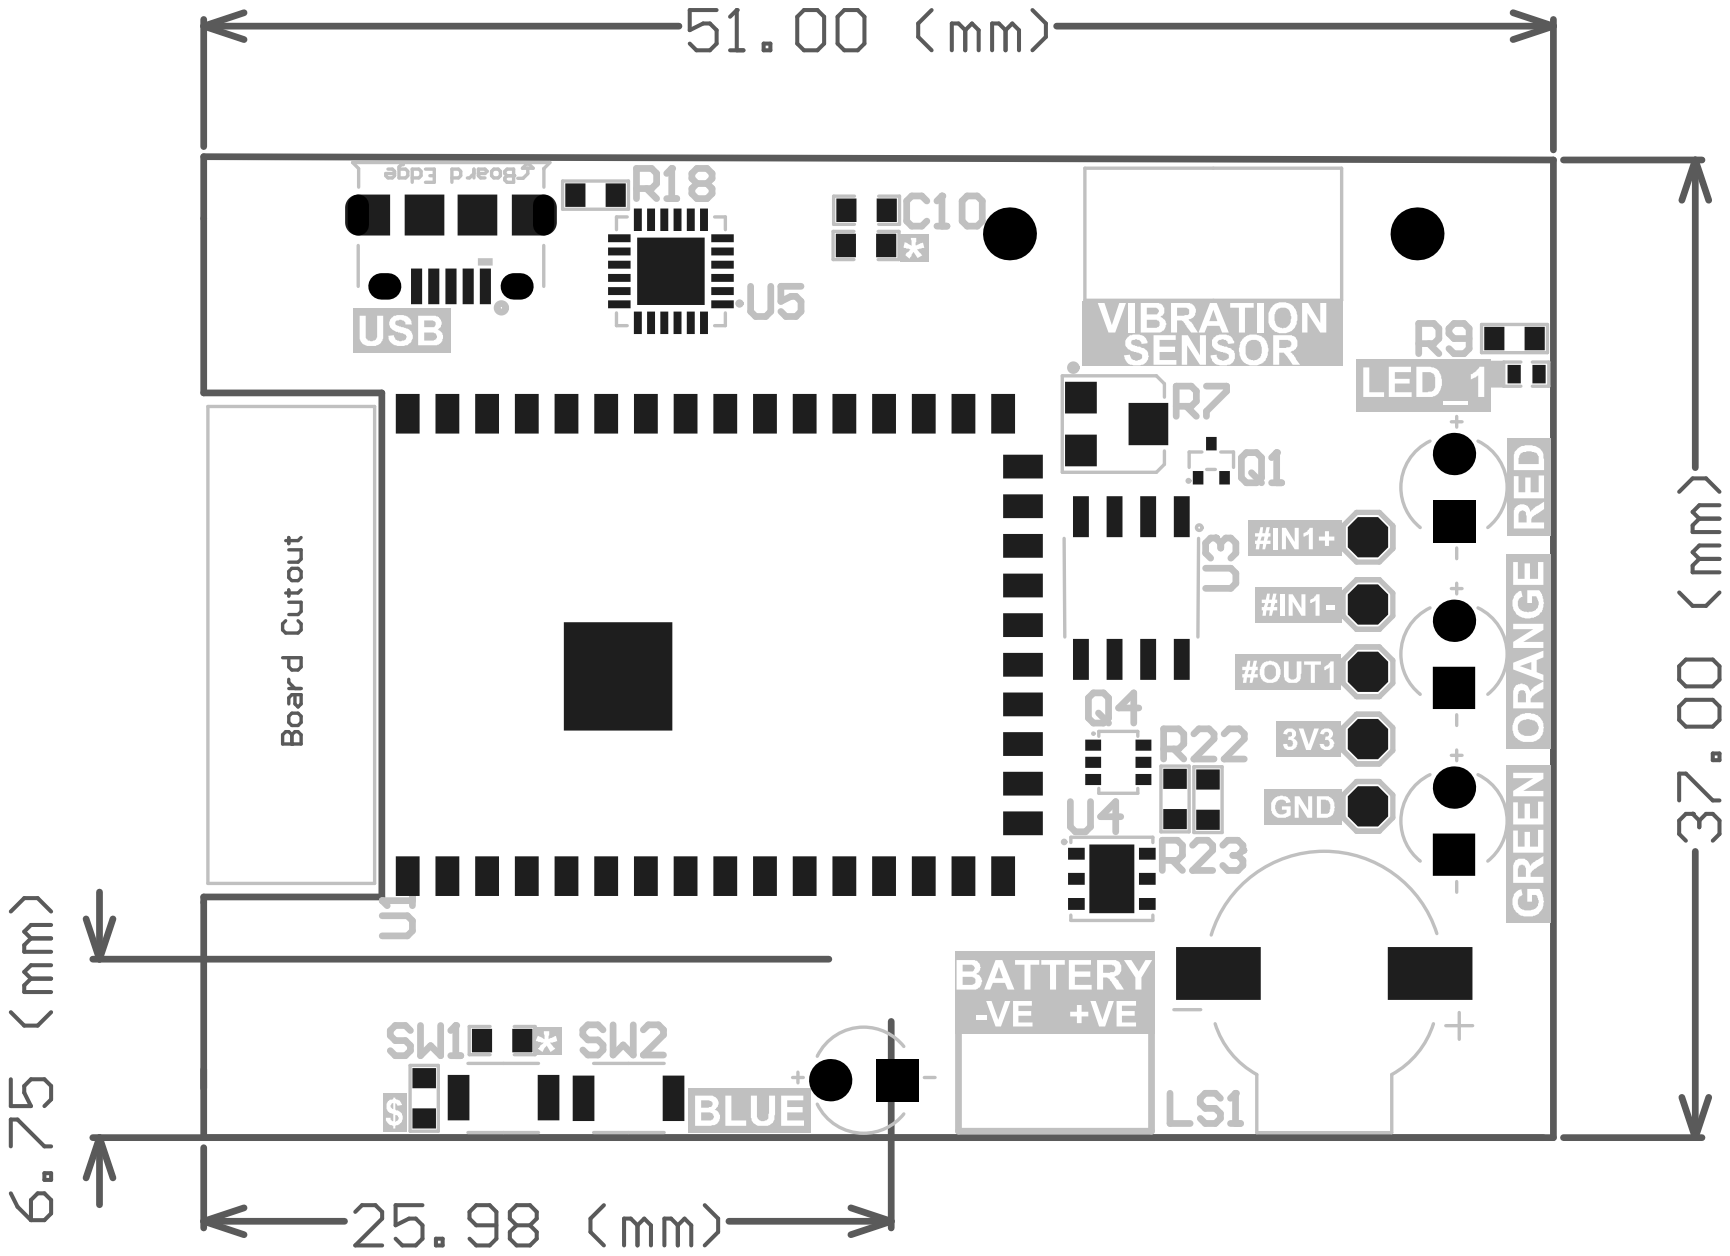
[picture p23: page 1]

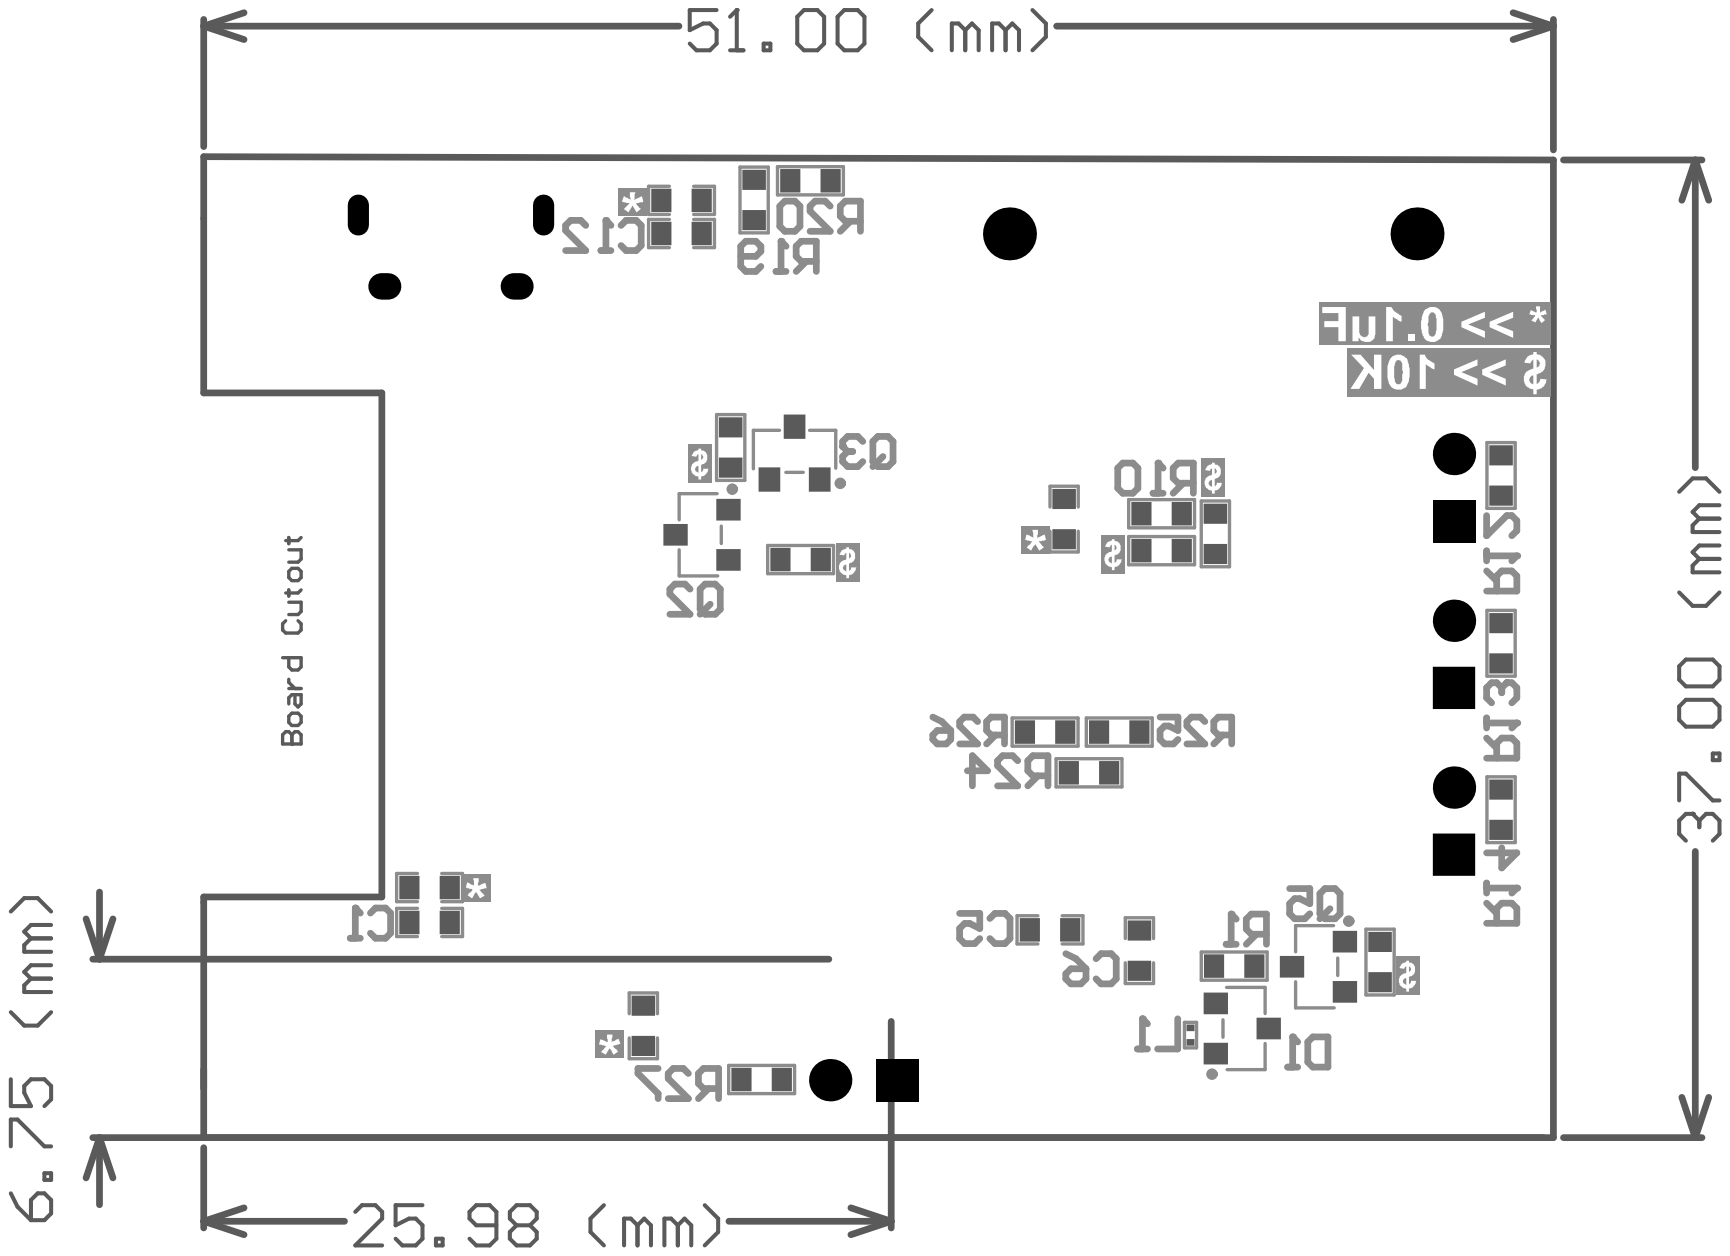
[picture p24: page 2]
