eSpark-Backup/shocksensor-george/Hardware-Designing/Deliverables/Schematic/Rackmonitor.pdf

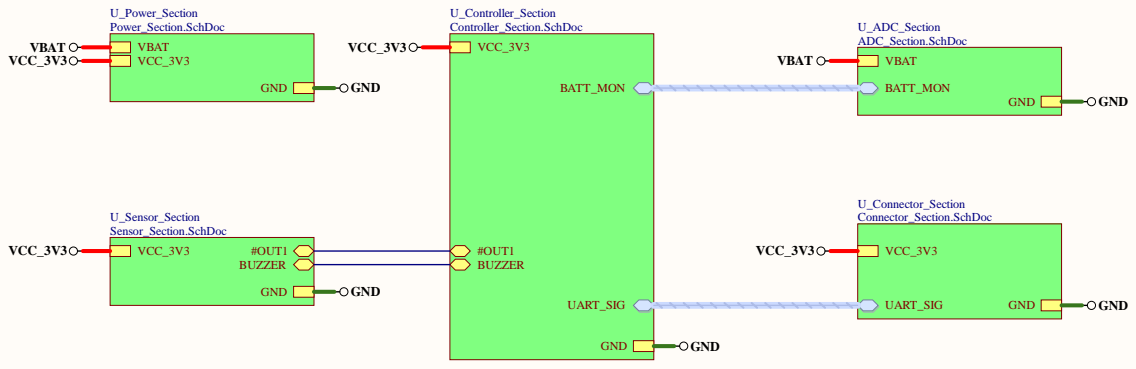
[picture p25: page 1]

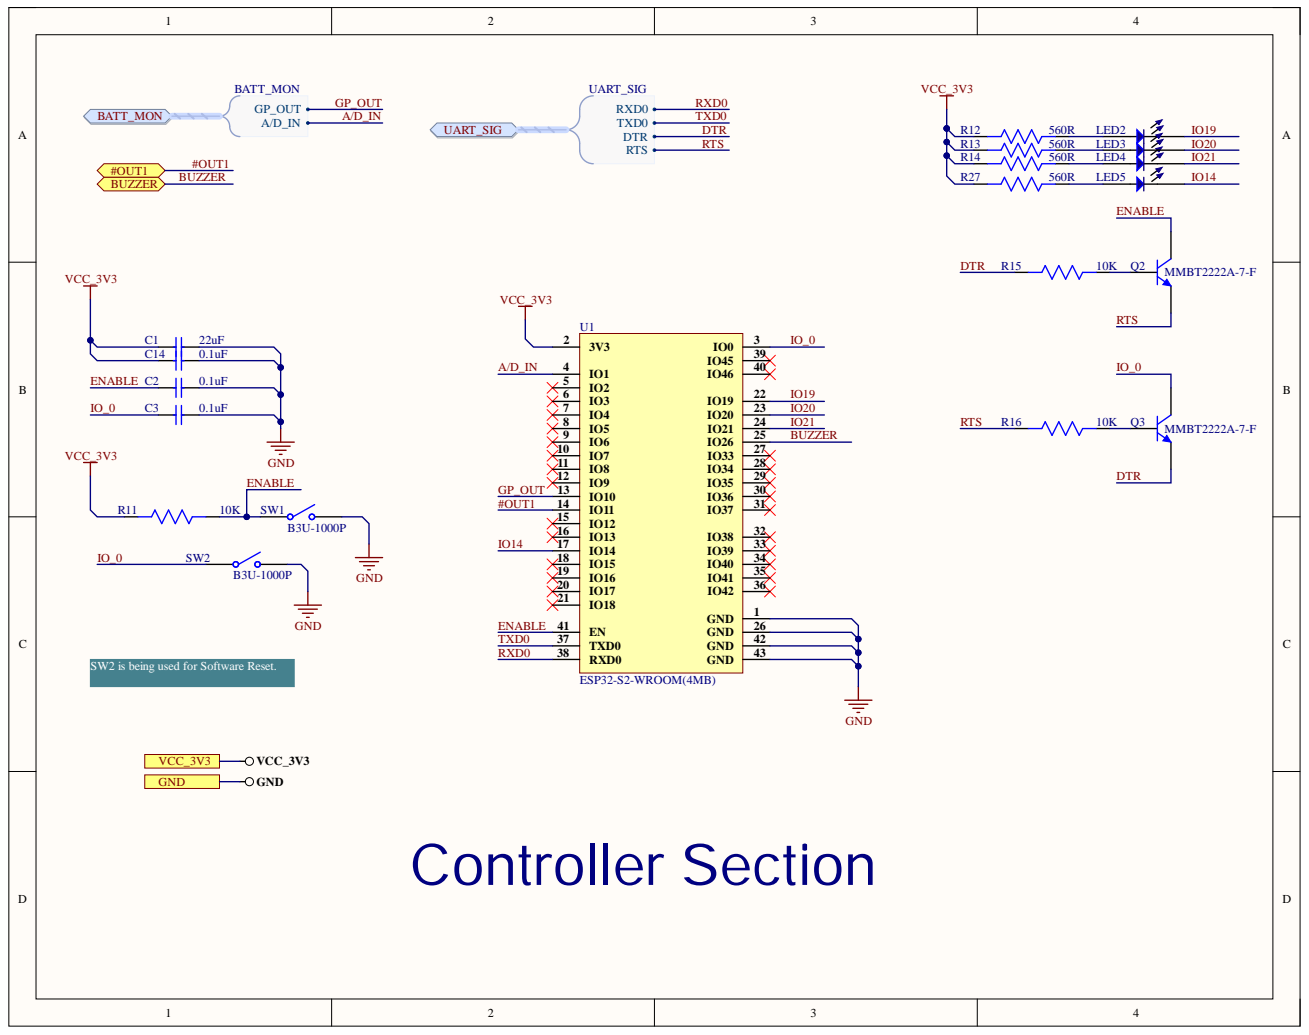
[picture p26: page 2]

SW2 is being used for Software Reset.

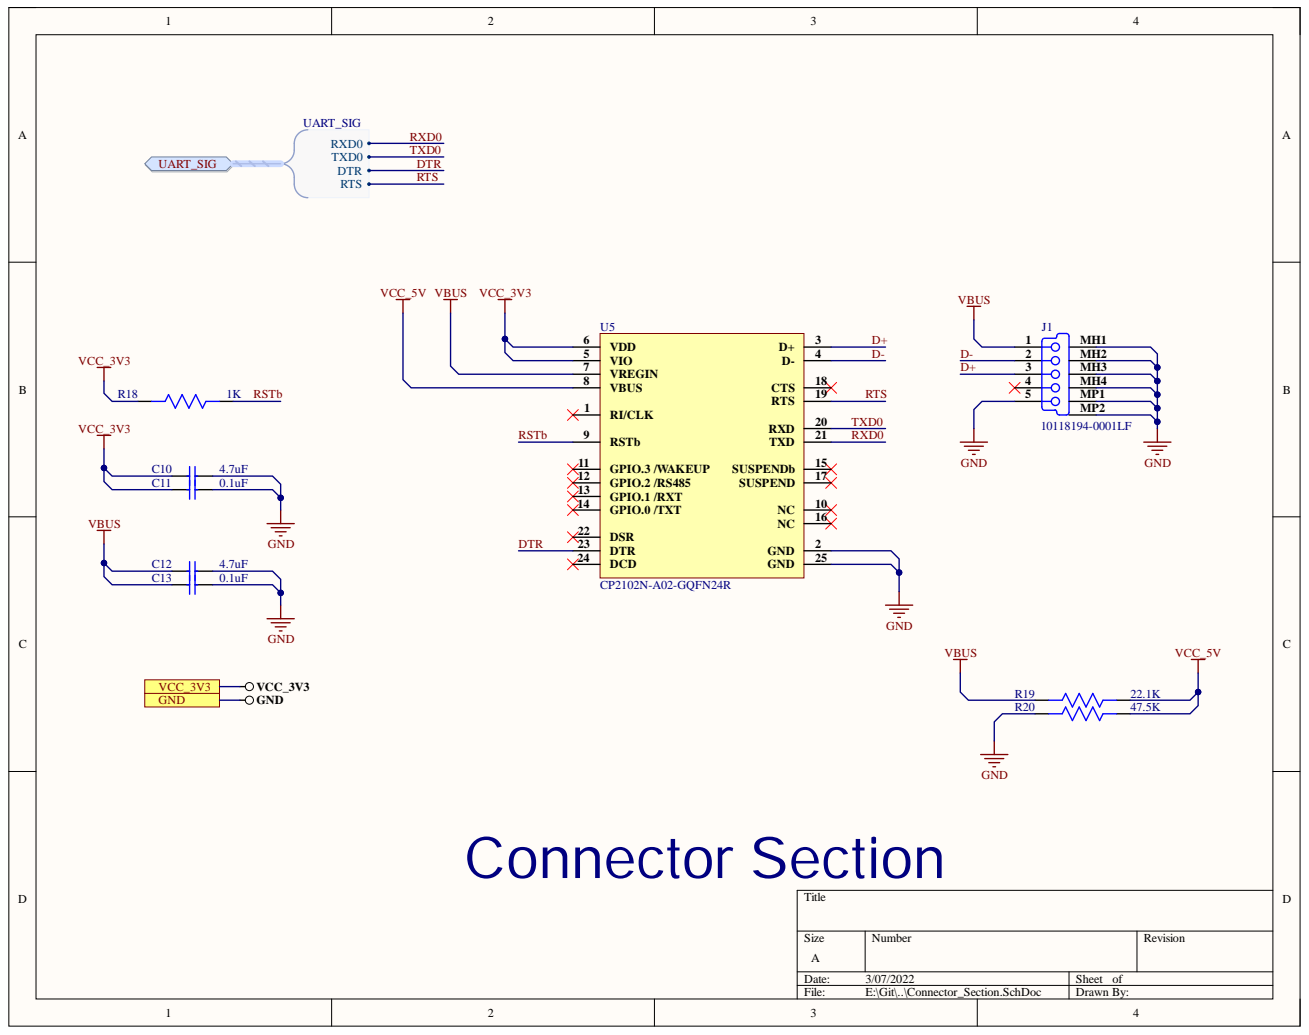
[picture p27: page 3]

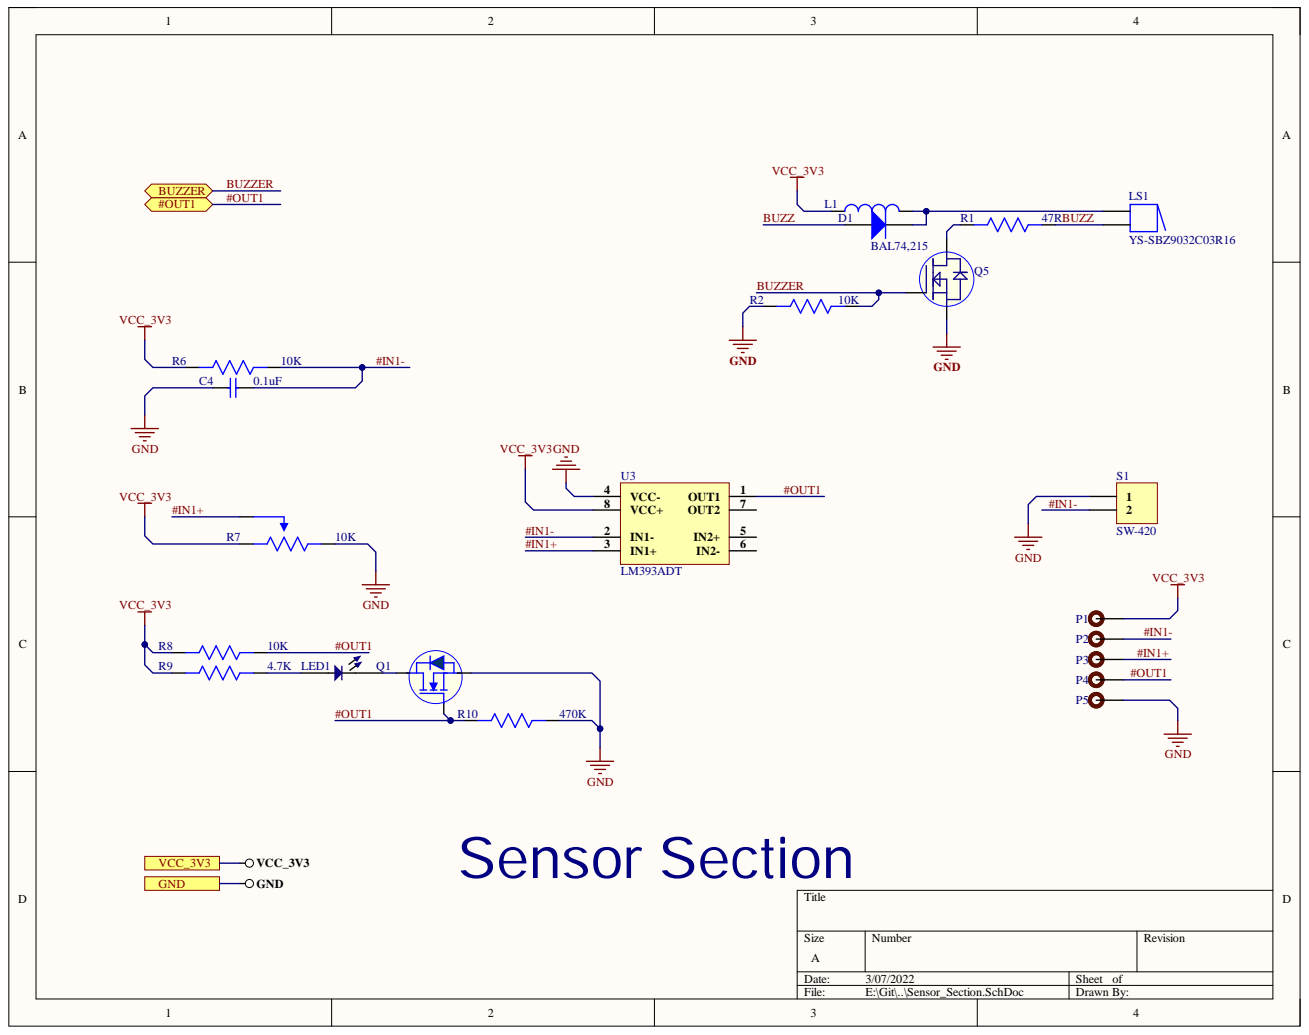
[picture p28: page 4]

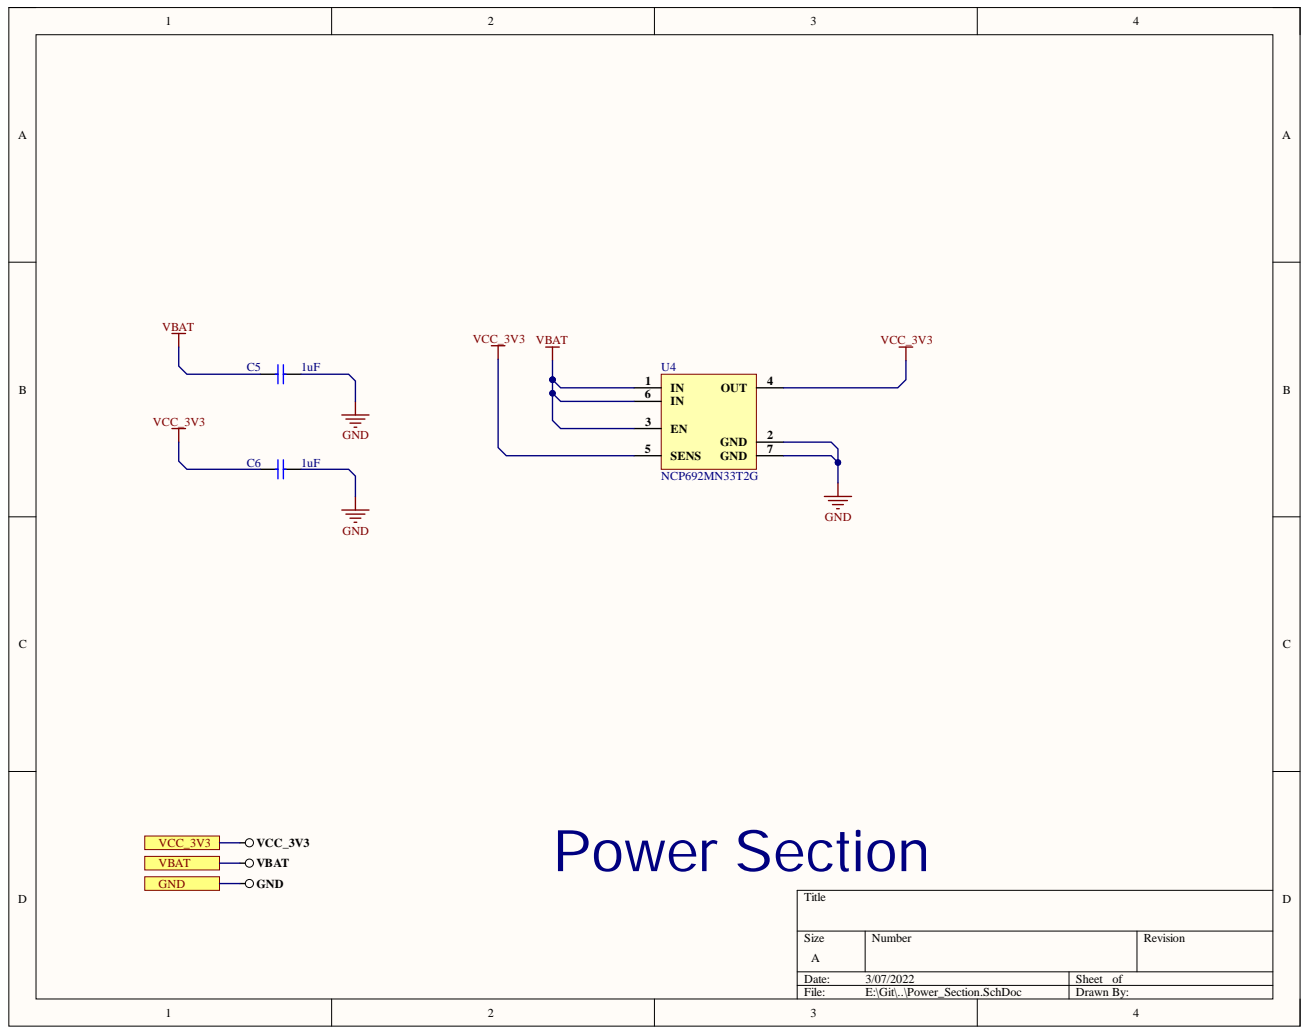
[picture p29: page 5]

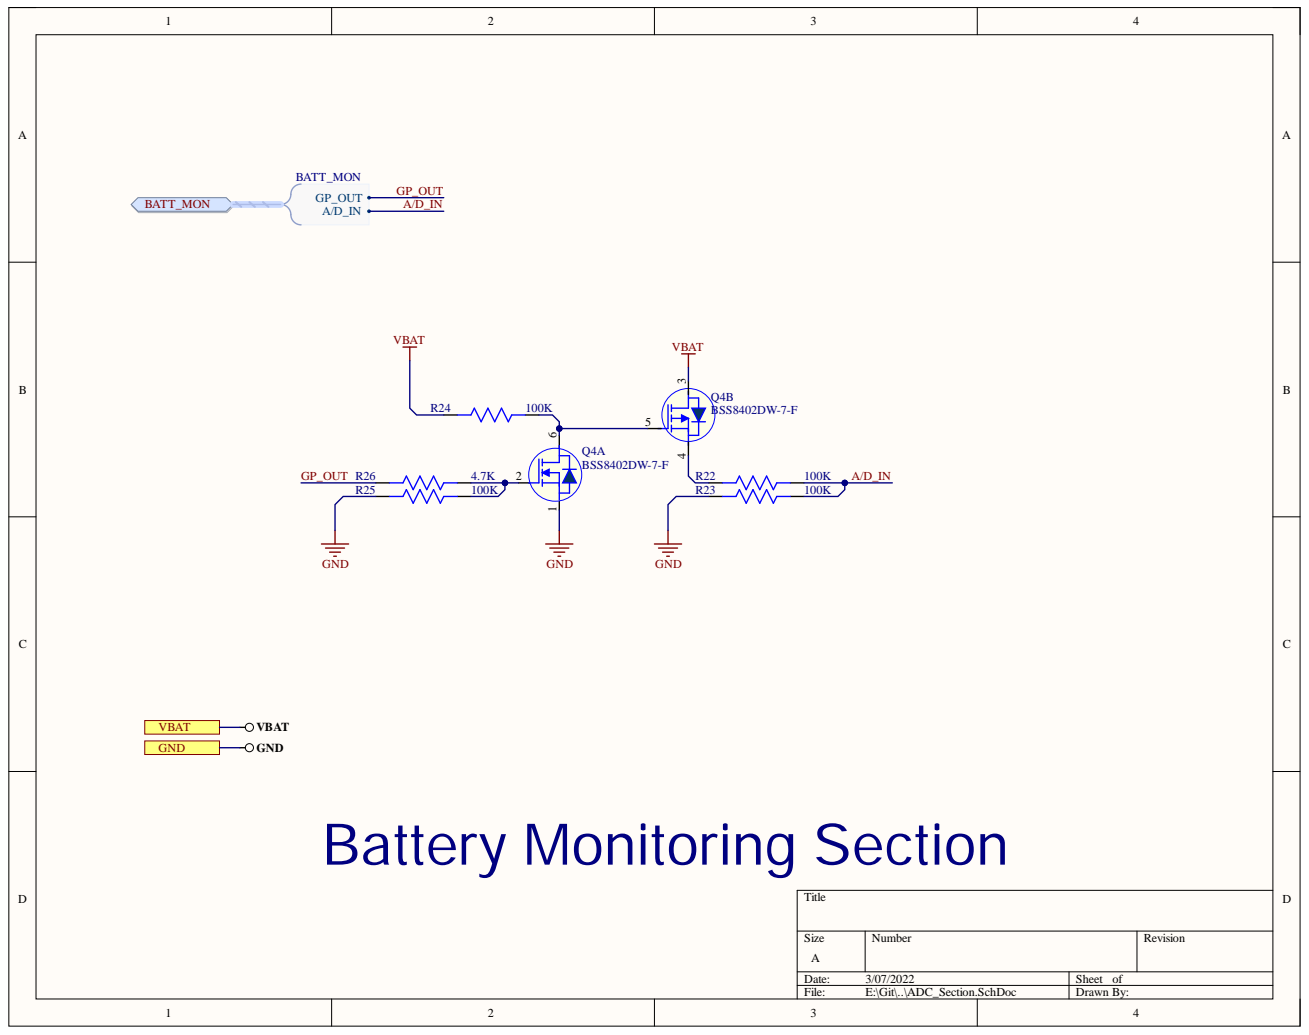
[picture p30: page 6]

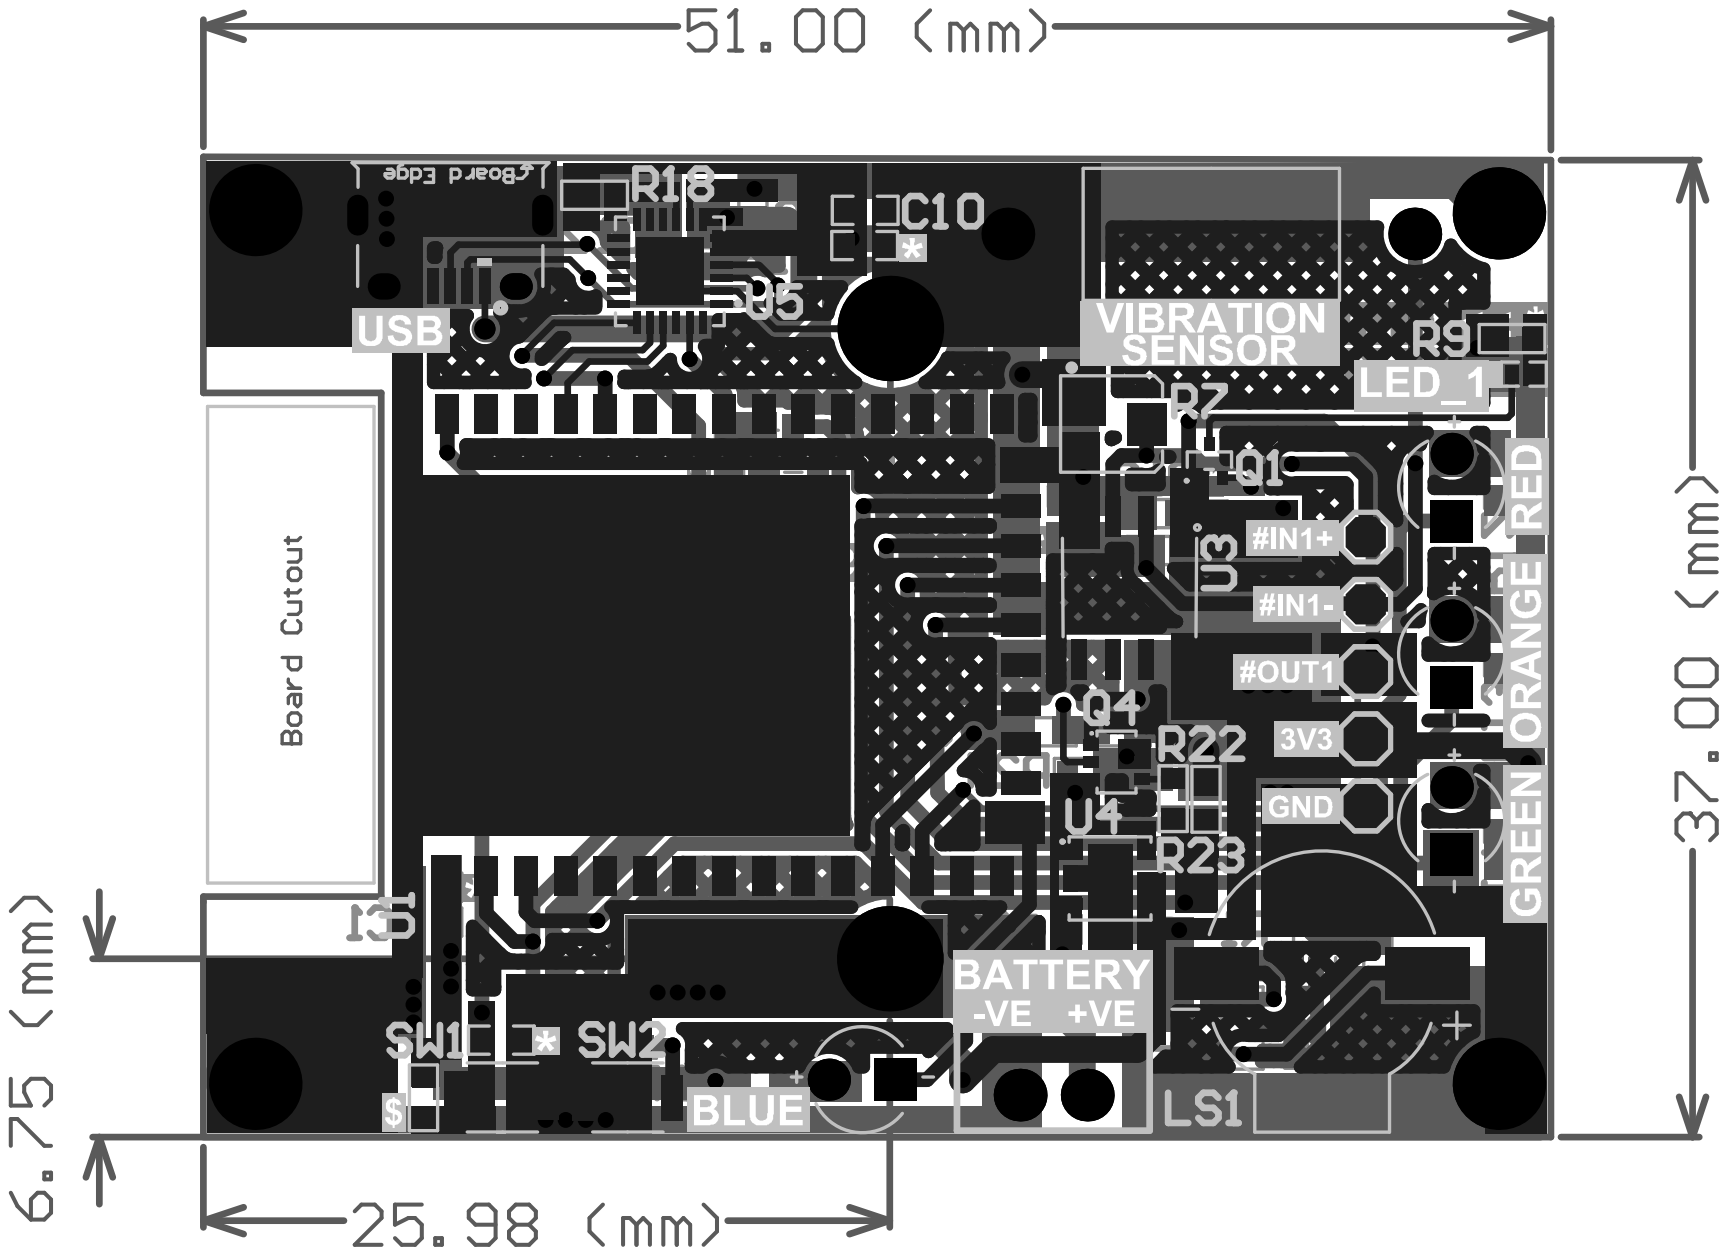
[picture p31: page 7]
