eSpark-Backup/shocksensor-george/Hardware-Designing/_Client Shared Files/Shock_Sensor_PCB/esp.pdf

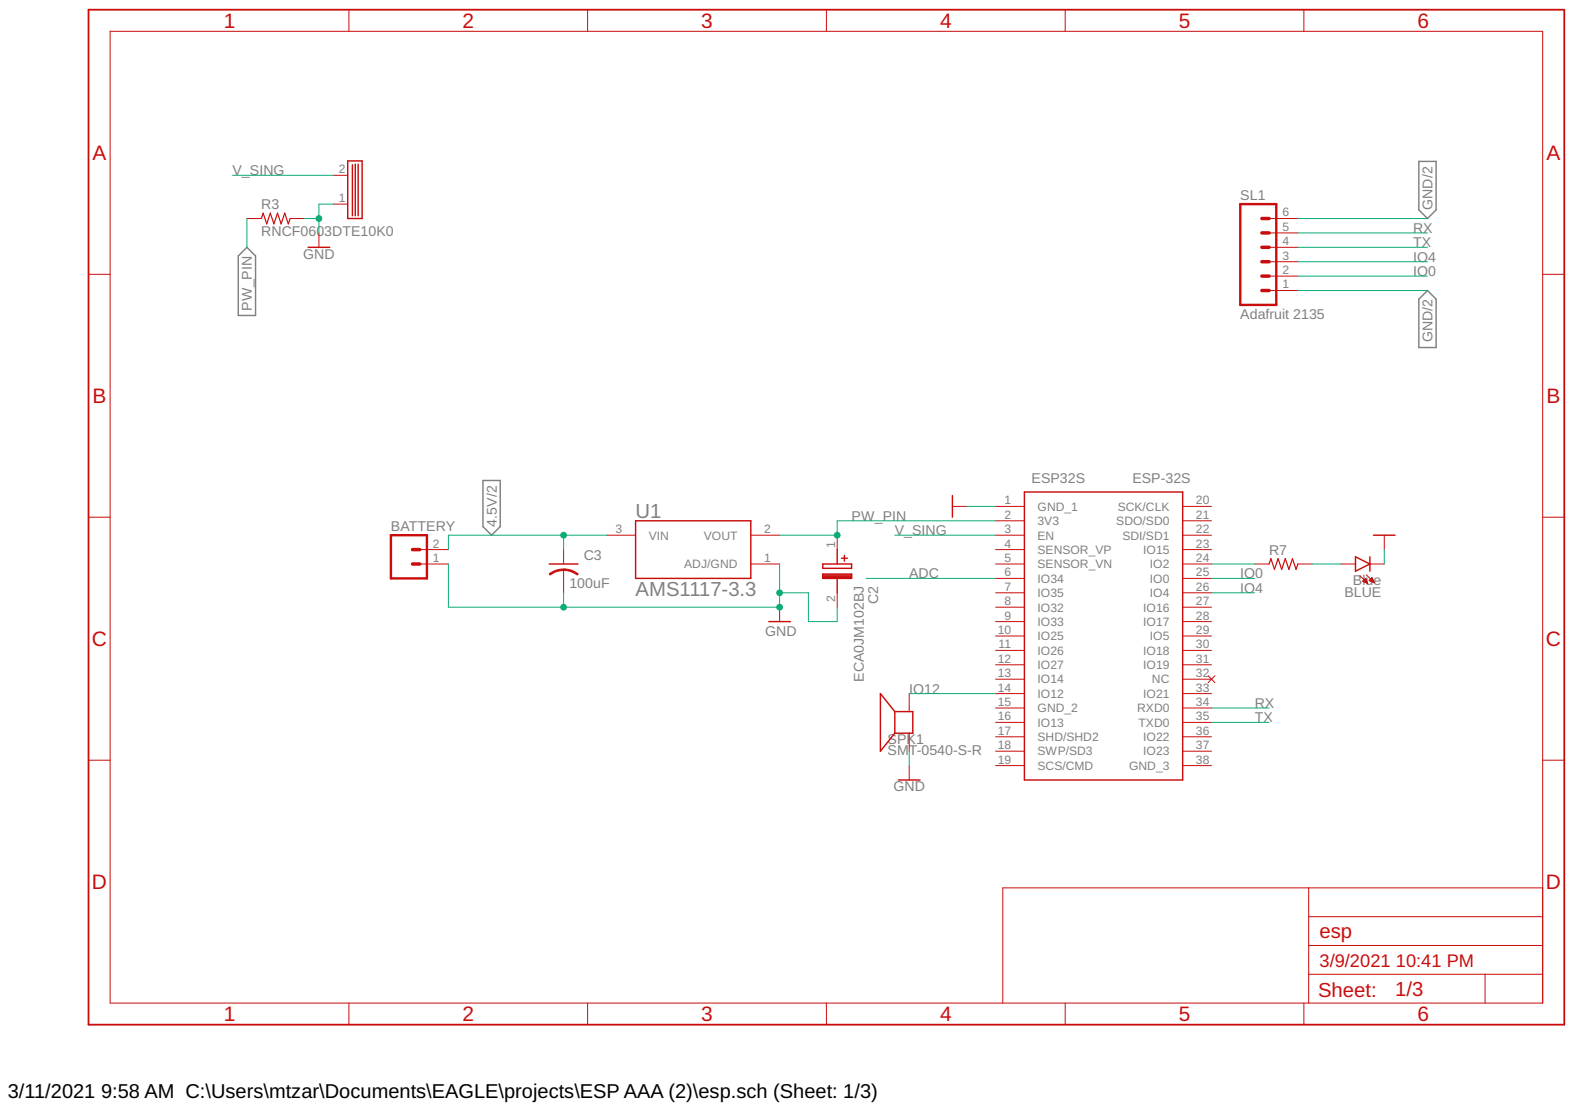
[picture p32: page 1]

3/11/2021 9:58 AM C:\Users\mtzar\Documents\EAGLE\projects\ESP AAA (2)\esp.sch (Sheet: 1/3)

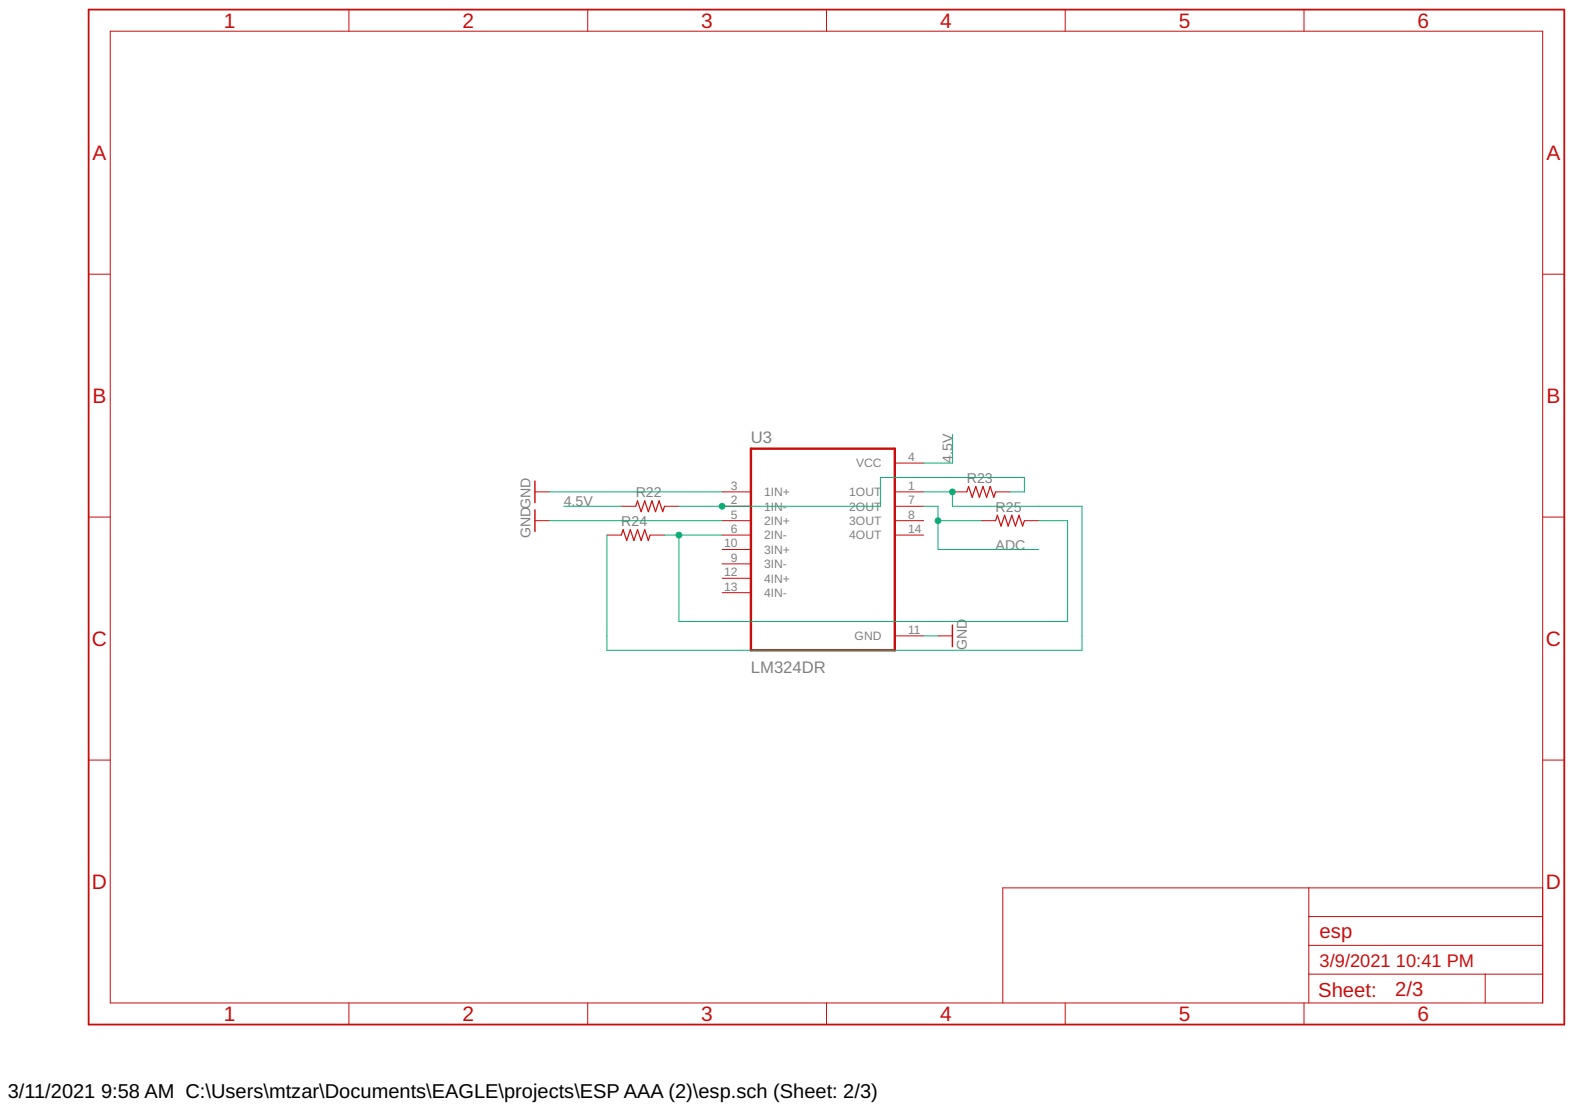
[picture p33: page 2]

3/11/2021 9:58 AM C:\Users\mtzar\Documents\EAGLE\projects\ESP AAA (2)\esp.sch (Sheet: 2/3)

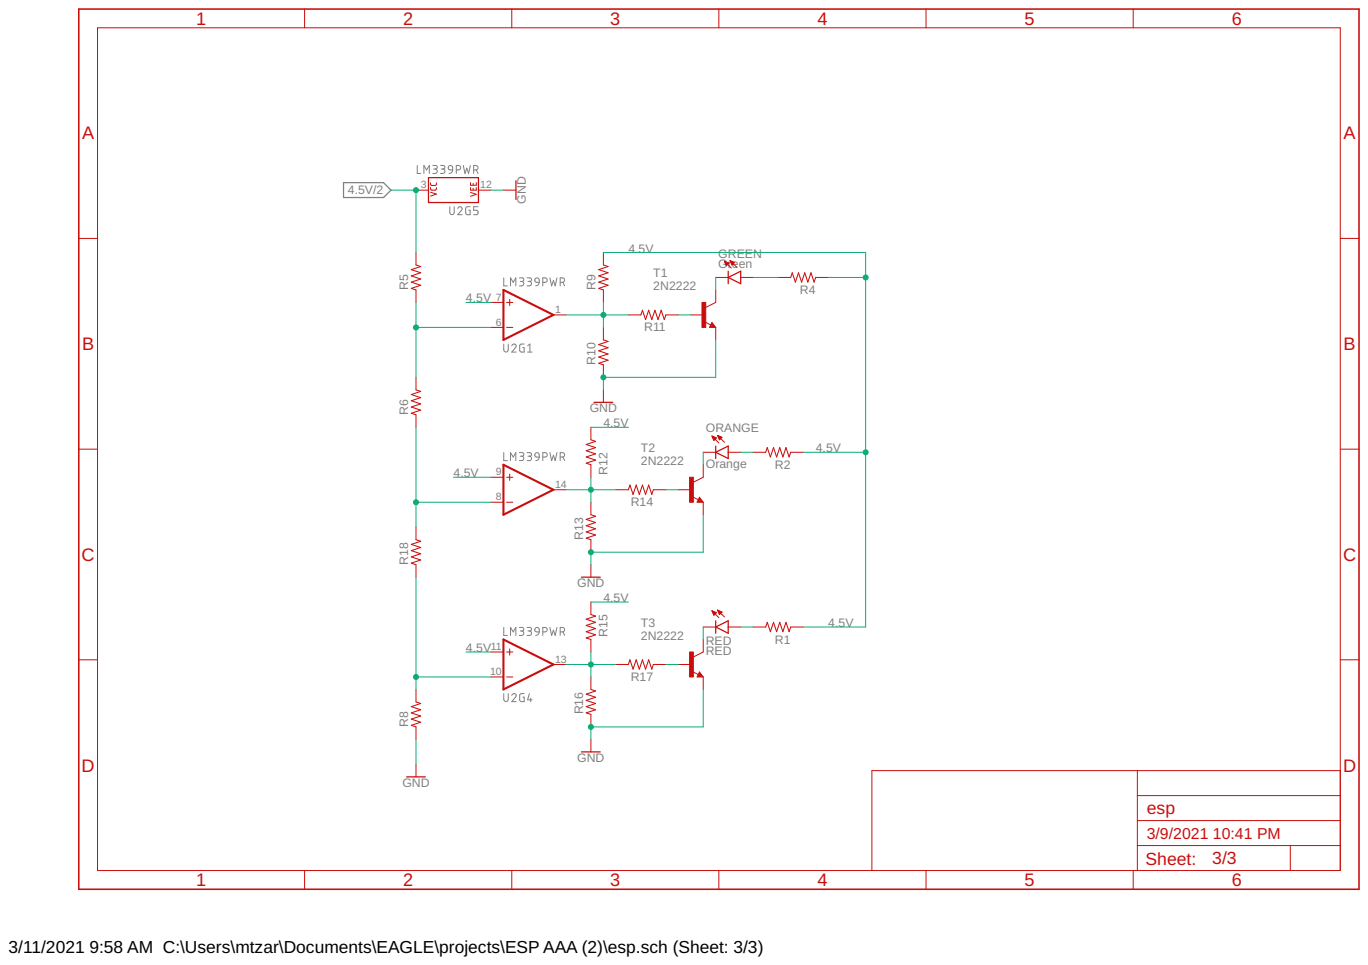
[picture p34: page 3]

3/11/2021 9:58 AM C:\Users\mtzar\Documents\EAGLE\projects\ESP AAA (2)\esp.sch (Sheet: 3/3)
