eSpark-Backup/shocksensor-george/(list of files, drawings)

Other design files:
Hardware-Designing/_Reference Design/George Task.PrjPcb
Hardware-Designing/_Reference Design/Sheet1.SchDoc
Hardware-Designing/Design-Files/ADC_Section.SchDoc
Hardware-Designing/Design-Files/Connector_Section.SchDoc
Hardware-Designing/Design-Files/Controller_Section.SchDoc
Hardware-Designing/Design-Files/Power_Section.SchDoc
Hardware-Designing/Design-Files/Rackmonitor.PrjPcb
Hardware-Designing/Design-Files/Sensor_Section.SchDoc
Hardware-Designing/Design-Files/Shock_Sensor.PcbDoc
Hardware-Designing/Design-Files/Top_Section.SchDoc
Hardware-Designing/Design_File/ADC_Seection.SchDoc
Hardware-Designing/Design_File/Connector_Section.SchDoc
Hardware-Designing/Design_File/Controller_Section.SchDoc
Hardware-Designing/Design_File/George_ShockSensor.PrjPcb
Hardware-Designing/Design_File/Power_Section.SchDoc
Hardware-Designing/Library-Files/George.PcbLib
Hardware-Designing/Library-Files/George.SchLib
