eSpark-Backup/shocksensor-george/Hardware-Designing/_Client Shared Files/Shock_Sensor_PCB/esp.brd

## EAGLE design Hardware-Designing/_Client Shared Files/Shock_Sensor_PCB/esp.brd (2021-03-16)

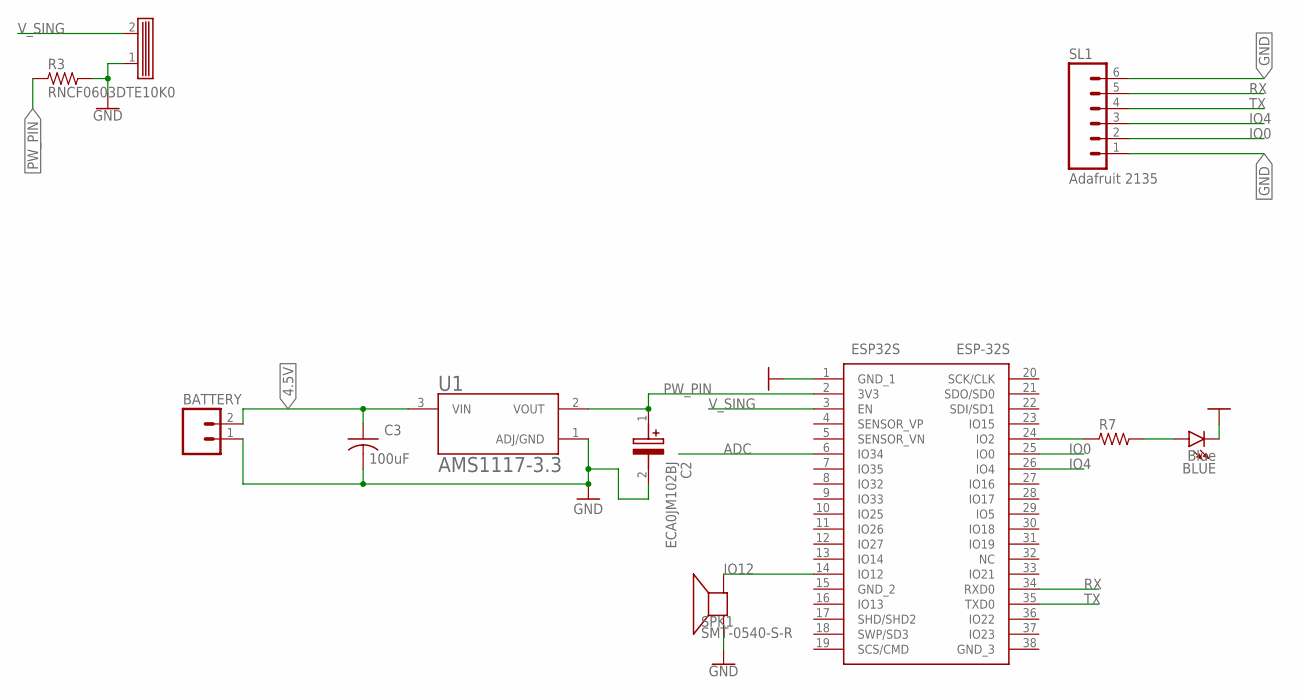
[picture p35: schematic esp.sch, sheet 1]

Parts:
BATTERY: MP-4-3 TAKACHI ELECTRONICS ENCLOSURE TAKACHI ELEC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; 02P
BLUE: Blue; LED3MM
C2: ECA0JM102BJ; CAPPRD350W65D825H1250
C3: 100uF; C0805K
ESP32S: ESP-32S
R3: RNCF0603DTE10K0; R0603
R7: ERJ-UP3J221V; R0201
SL1: Adafruit 2135; 06P
SPK1: SMT-0540-S-R
U1: AMS1117-3.3; SOT229P700X180-4N
U$1: SW-18015P

Connections:
4.5V: BATTERY.2, C3.1, U1.3 (VIN); also elsewhere on the board
4.5V1: ESP32S.24 (IO2), R7.1
ADC: ESP32S.6 (IO34); also elsewhere on the board
GND: BATTERY.1, BLUE.K (C), C2.2 (-), C3.2, ESP32S.1 (GND_1), R3.2, SL1.1, SL1.6, SPK1.- (+), U1.1 (ADJ/GND), U$1.1 (+VE); also elsewhere on the board
IO0: ESP32S.25 (IO0), SL1.2
IO4: ESP32S.26 (IO4), SL1.3
IO12: ESP32S.14 (IO12), SPK1.+ (-)
unnamed: BLUE.A, R7.2
PW_PIN: C2.1 (+), ESP32S.2 (3V3), R3.1, U1.2 (VOUT)
RX: ESP32S.34 (RXD0), SL1.5
TX: ESP32S.35 (TXD0), SL1.4
V_SING: ESP32S.3 (EN), U$1.2 (-VE)

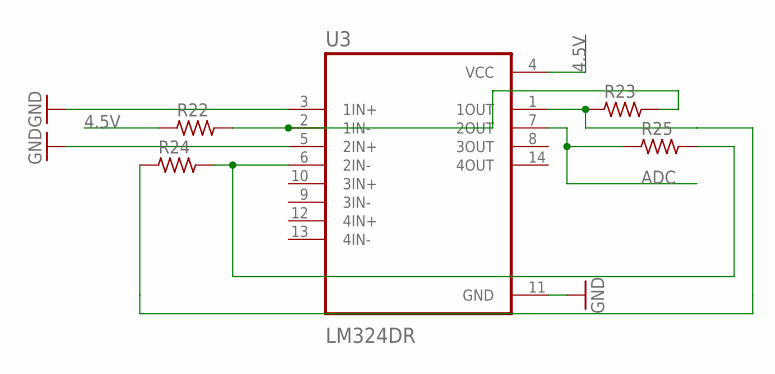
[picture p36: schematic esp.sch, sheet 2]

Parts:
R22: RMCF0201JT6K20; R0201
R23, R24, R25: RC0201JR-0710KL; R0201
U3: LM324DR; SOIC127P600X175-14N

Connections:
4.5V: R22.1, U3.4 (VCC); also elsewhere on the board
ADC: R25.1, U3.7 (2OUT); also elsewhere on the board
GND: U3.3 (1IN+), U3.5 (2IN+), U3.11 (GND); also elsewhere on the board
unnamed: R22.2, R23.2, U3.2 (1IN-)
unnamed: R24.2, R25.2, U3.6 (2IN-)
unnamed: R23.1, R24.1, U3.1 (1OUT)

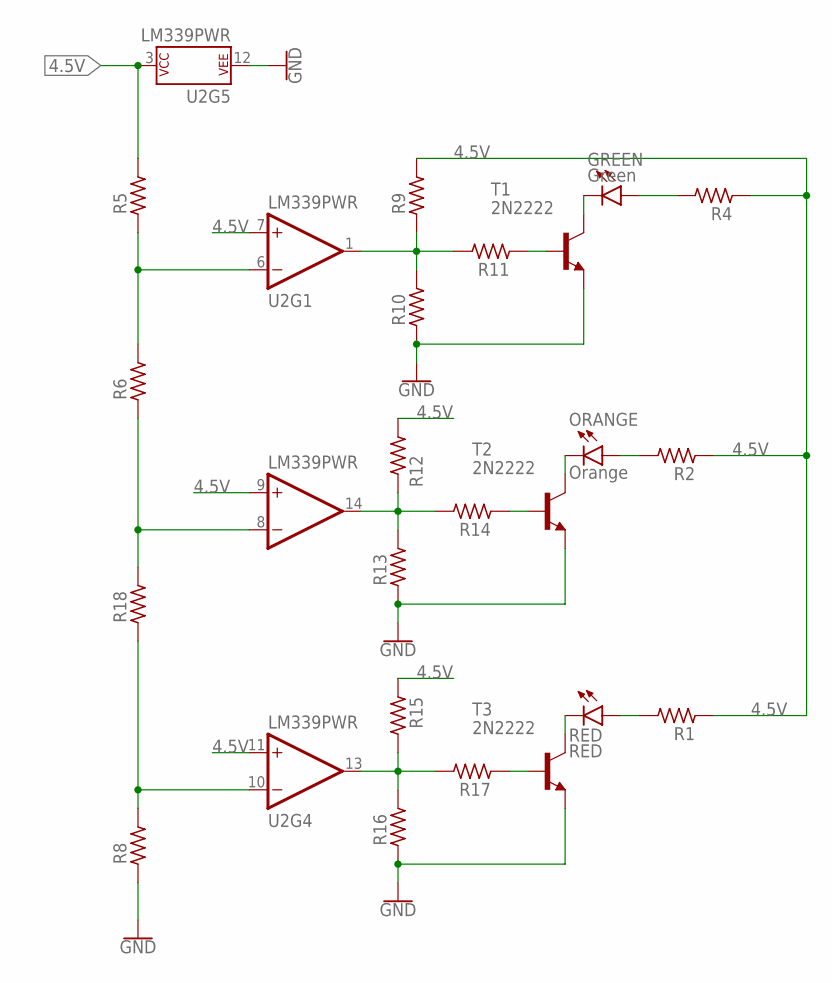
[picture p37: schematic esp.sch, sheet 3]

Parts:
GREEN: Green; LED3MM
ORANGE: Orange; LED3MM
R1, R2, R4: ERJ-UP3J221V; R0201
R5, R8, R9, R10, R11, R12, R13, R14, R15, R16, R17: RMCF0201JT10K0; R0201
R6: RMCF0201JT20K0; R0201
R18: PNM0805E5002BST5; C0805
RED: RED; LED3MM
T1, T2, T3: 2N2222; TO92-EBC-OVAL
U2: LM339PWR; TSSOP-14

Connections:
4.5V: R1.1, R2.1, R4.1, R5.2, R9.2, R12.1, R15.1, U2.3 (P$V+), U2.7 (+IN), U2.9 (+IN), U2.11 (+IN); also elsewhere on the board
GND: R8.1, R10.1, R13.1, R16.1, T1.E, T2.E, T3.E, U2.12 (P$V-); also elsewhere on the board
unnamed: GREEN.A, R4.2
unnamed: ORANGE.A, R2.2
unnamed: R1.2, RED.A
unnamed: R8.2, R18.1, U2.10 (-IN)
unnamed: R6.1, R18.2, U2.8 (-IN)
unnamed: R5.1, R6.2, U2.6 (-IN)
unnamed: R9.1, R10.2, R11.2, U2.1 (OUT)
unnamed: R12.2, R13.2, R14.2, U2.14 (OUT)
unnamed: R15.2, R16.2, R17.2, U2.13 (OUT)
unnamed: R11.1, T1.B
unnamed: R14.1, T2.B
unnamed: R17.1, T3.B
unnamed: GREEN.K (C), T1.C
unnamed: ORANGE.K (C), T2.C
unnamed: RED.K (C), T3.C

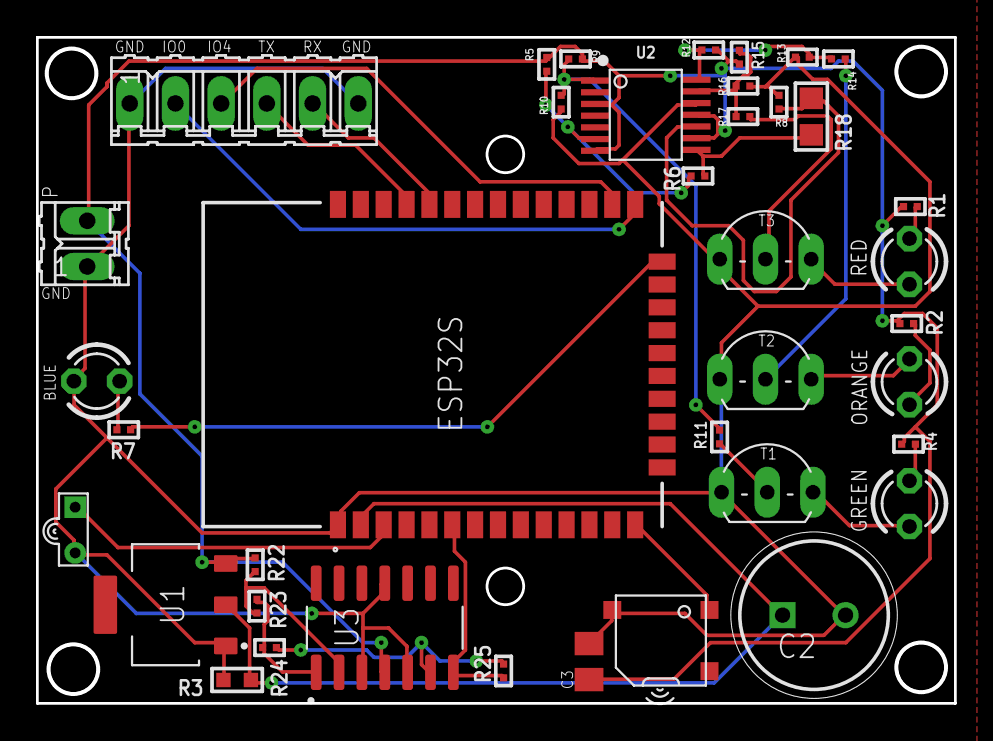
[picture p38: board esp.brd from above]

Board: 2 copper layers, 51.0 x 37.0 mm, 39 parts (0 on the bottom side), 30 nets.
