eSpark-Backup/shocksensor-george/Firmware-Development/Phase-2(Custom-Board)/LED_test/LED_test.ino

#define GREEN_LED 27
#define ORANGE_LED 26
#define RED_LED 25

void setup() {
  // put your setup code here, to run once:
  pinMode(GREEN_LED, OUTPUT);
  pinMode(ORANGE_LED, OUTPUT);
  pinMode(RED_LED, OUTPUT);

  //Serial.begin(115200);

  digitalWrite(GREEN_LED, LOW);
  digitalWrite(ORANGE_LED, LOW);
  digitalWrite(RED_LED, LOW);
}

void loop() {
}
