eSpark-Backup/shocksensor-george/Firmware-Development/Phase-2(Custom-Board)/LED_test_George/LED_test_George.ino

#define GREEN_LED 21
#define ORANGE_LED 20
#define RED_LED 19

void setup() {
  // put your setup code here, to run once:
  pinMode(GREEN_LED, OUTPUT);
  pinMode(ORANGE_LED, OUTPUT);
  pinMode(RED_LED, OUTPUT);

  //Serial.begin(115200);
}

void loop() {
  digitalWrite(RED_LED, HIGH);
  digitalWrite(ORANGE_LED, HIGH);
  digitalWrite(GREEN_LED, HIGH);
  delay(1000);

  digitalWrite(RED_LED, LOW);
  digitalWrite(ORANGE_LED, LOW);
  digitalWrite(GREEN_LED, LOW);
  delay(1000);
}
