eSpark-Backup/shocksensor-george/(commit log)

2021-08-31 George code
    Battery Status Test Code + Battery status code added to final code.
2021-09-03 Battery status added to cloud
    //
2021-09-07 Schematic Design and some parts addition in Library
2021-09-08 Schematic design and Parts addition
2021-09-08 Deep-Sleep-LED-Test
    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
2021-09-09 Changes in Schematic
2021-09-09 latest Changes in Schematic
2021-09-09 Latest Changes in Schematic design
2021-09-09 Changes in signals at sensor pins
2021-09-10 PCB Parts Placement and Routing
2021-09-10 Updated BOM (Digikey BOM) Completed ,(LCSC BOM) Remaining.
2021-09-13 PCB ROUTING
2021-09-16 Changes in Schematic and PCB Routing
2021-09-18 Dimension of PCB
2021-09-20 updating LCSC BOM(Still remaing)
2021-09-21 Updated BOM LCSC Or Digikey
2021-09-25 PCB and Schematic updated Acc to library changes
2021-10-02 led and battery points placement
2021-10-04 Updated library and Schematic all TH LED are corrected and replays in Schematic.
2021-10-04 PCB updated according toLibrary changes
2021-10-05 esp32-s-ai datasheet added to client files.
2021-10-08 LEDs Updated in Library schematic and PCB
2021-10-09 PCB updated acc to review
2021-10-11 ESP32 and USB updated in PCB
2021-10-11 Latest BOM
2021-10-23 Latest Files Esp32 Change Library and Schematic
2021-10-23 Latest Files 3d Body change ESP32
2021-10-23 PCB updated according to changes
2021-10-28 3D body of sensor(SW-420) updated in PCB
2021-10-29 PCB Updated and Deliverables
2021-11-02 Updated PDF PCB Section remove
2021-11-03 Step files created. New Gerber and NC Drill Files created.
2021-11-10 Digikey BOM update kr dia ha LCSC BOM remaining ha
2021-11-11 #10 LCSC BOM Update kr dia ha jo parts LCSC per Non stock han wo Quotation k lye issue per mention kr diye han
2022-02-08 Netlabel names also changed in PCB; no deliverables creating needed
2022-02-08 added code for LED test, Sleep test and shock detection
2022-02-14 added battery monitoring code in Final code - remaining testing
2022-02-14 Tested successfully integration of battery monitoring to existing code
2022-02-15 improvised code -reduced current consumption and wakeup time
2022-02-15 added library function prototypes
2022-02-17 latest George code, battery optimized and avoids resetting
2022-02-19 update library to use ArduinoJson6
2022-02-26 minor changes done in PCBacc #24
2022-02-26 Minor Changes in PCB after review. Refer to PCB Designing-Review of PCB #24
